minhthangbk/ztachip/HW/src/ztachip_pkg.vhd

---------------------------------------------------------------------------
-- Copyright [2014] [Ztachip Technologies Inc]
--
-- Author: Vuong Nguyen
--
-- Licensed under the Apache License, Version 2.0 (the "License");
-- you may not use this file except in compliance with the License.
-- You may obtain a copy of the License at
--
-- http://www.apache.org/licenses/LICENSE-2.0
--
-- Unless required by applicable law or agreed to in writing, software
-- distributed under the License is distributed on an "AS IS" BASIS,
-- WITHOUT WARRANTIES OR CONDITIONS OF ANY KIND, either express or implied.
-- See the License for the specific language governing permissions and
-- limitations under the License.
---------------------------------------------------------------------------

--------------- 
-- This file defines constants that are used by ztachip implementation
-- Contains component declaration
---------------

library std;
use std.standard.all;
LIBRARY ieee;
USE ieee.std_logic_1164.all;
use IEEE.numeric_std.all;
use IEEE.MATH_REAL.ALL;
use work.config.all;

package ztachip_pkg is

---------
-- Number of threads
---------

constant tid_max_c:integer:=16;

subtype tid_t is unsigned(3 DOWNTO 0);

subtype tid_mask_t  is std_logic_vector(tid_t'length-1 downto 0);

--------
-- Message queue to communicate with host
--------

constant msgq_in_num_c          :integer:=2;                        -- Number of inbox fifo

constant msgq_in_depth_c        :integer:=11;                       -- number of bits required to represent number of inbox messages

constant msgq_in_max_c          :integer:=(2**msgq_in_depth_c-1);   -- inbox size

constant msgq_out_depth_c       :integer:=11;                       -- number of bits required to represent number of outbox messages

constant msgq_out_max_c         :integer:=(2**msgq_out_depth_c-1);  -- outbox size

----------
-- AXI read bus signal definitions
----------

subtype axi_araddr_t is std_logic_vector(31 downto 0);
subtype axi_arlen_t is std_logic_vector(7 downto 0);
subtype axi_arvalid_t is std_logic;     
subtype axi_arid_t is std_logic_vector(0 downto 0);
subtype axi_arlock_t is std_logic_vector(0 downto 0);
subtype axi_arcache_t is std_logic_vector(3 downto 0);
subtype axi_arprot_t is std_logic_vector(2 downto 0);
subtype axi_arqos_t is std_logic_vector(3 downto 0);
subtype axi_rid_t is std_logic_vector(0 downto 0);             
subtype axi_rvalid_t is std_logic;
subtype axi_rlast_t is std_logic;
subtype axi_rdata_t is std_logic_vector(31 downto 0);
subtype axi_rdata64_t is std_logic_vector(63 downto 0);
subtype axi_rdata128_t is std_logic_vector(127 downto 0);
subtype axi_rresp_t is std_logic_vector(1 downto 0);
subtype axi_arready_t is std_logic;
subtype axi_rready_t is std_logic;
subtype axi_arburst_t is std_logic_vector(1 downto 0);
subtype axi_arsize_t is std_logic_vector(2 downto 0);

type axi_araddrs_t is array(natural range <>) of axi_araddr_t;
type axi_arlens_t is array(natural range <>) of axi_arlen_t;
type axi_arvalids_t is array(natural range <>) of axi_arvalid_t; 
type axi_arids_t is array(natural range <>) of axi_arid_t;
type axi_arlocks_t is array(natural range <>) of axi_arlock_t;
type axi_arcaches_t is array(natural range <>) of axi_arcache_t;
type axi_arprots_t is array(natural range <>) of axi_arprot_t;
type axi_arqoss_t is array(natural range <>) of axi_arqos_t;
type axi_rids_t is array(natural range <>) of axi_rid_t;
type axi_rvalids_t is array(natural range <>) of axi_rvalid_t;
type axi_rlasts_t is array(natural range <>) of axi_rlast_t;
type axi_rdatas_t is array(natural range <>) of axi_rdata_t;
type axi_rdata64s_t is array(natural range <>) of axi_rdata64_t;
type axi_rdata128s_t is array(natural range <>) of axi_rdata128_t;
type axi_rresps_t is array(natural range <>) of axi_rresp_t;
type axi_arreadys_t is array(natural range <>) of axi_arready_t;
type axi_rreadys_t is array(natural range <>) of axi_rready_t;
type axi_arbursts_t is array(natural range <>) of axi_arburst_t;
type axi_arsizes_t is array(natural range <>) of axi_arsize_t;

---------------------
-- AXI write bus signals
---------------------

subtype axi_awaddr_t is std_logic_vector(31 downto 0);
subtype axi_awlen_t is std_logic_vector(7 downto 0);
subtype axi_awvalid_t is std_logic;
subtype axi_wvalid_t is std_logic;
subtype axi_wdata_t is std_logic_vector(31 downto 0);
subtype axi_wdata64_t is std_logic_vector(63 downto 0);
subtype axi_wdata128_t is std_logic_vector(127 downto 0);
subtype axi_wlast_t is std_logic;
subtype axi_wstrb_t is std_logic_vector(3 downto 0);
subtype axi_wstrb8_t is std_logic_vector(7 downto 0);
subtype axi_wstrb16_t is std_logic_vector(15 downto 0);
subtype axi_awready_t is std_logic;
subtype axi_wready_t is std_logic;
subtype axi_bresp_t is std_logic_vector(1 downto 0);
subtype axi_bid_t is std_logic_vector(0 downto 0);
subtype axi_bvalid_t is std_logic;
subtype axi_awburst_t is std_logic_vector(1 downto 0);
subtype axi_awcache_t is std_logic_vector(3 downto 0);
subtype axi_awid_t is std_logic_vector(0 downto 0);
subtype axi_awlock_t is std_logic_vector(0 downto 0);
subtype axi_awprot_t is std_logic_vector(2 downto 0);
subtype axi_awqos_t is std_logic_vector(3 downto 0);
subtype axi_awsize_t is std_logic_vector(2 downto 0);
subtype axi_bready_t is std_logic;

type axi_awaddrs_t is array(natural range <>) of axi_awaddr_t;
type axi_awlens_t is array(natural range <>) of axi_awlen_t;
type axi_awvalids_t is array(natural range <>) of axi_awvalid_t;
type axi_wvalids_t is array(natural range <>) of axi_wvalid_t;
type axi_wdatas_t is array(natural range <>) of axi_wdata_t;
type axi_wdata64s_t is array(natural range <>) of axi_wdata64_t;
type axi_wdata128s_t is array(natural range <>) of axi_wdata128_t;
type axi_wlasts_t is array(natural range <>) of axi_wlast_t;
type axi_wstrbs_t is array(natural range <>) of axi_wstrb_t;
type axi_wstrb8s_t is array(natural range <>) of axi_wstrb8_t;
type axi_wstrb16s_t is array(natural range <>) of axi_wstrb16_t;
type axi_awreadys_t is array(natural range <>) of axi_awready_t;
type axi_wreadys_t is array(natural range <>) of axi_wready_t;
type axi_bresps_t is array(natural range <>) of axi_bresp_t;
type axi_bids_t is array(natural range <>) of axi_bid_t;
type axi_bvalids_t is array(natural range <>) of axi_bvalid_t;
type axi_awbursts_t is array(natural range <>) of axi_awburst_t;
type axi_awcaches_t is array(natural range <>) of axi_awcache_t;
type axi_awids_t is array(natural range <>) of axi_awid_t;
type axi_awlocks_t is array(natural range <>) of axi_awlock_t;
type axi_awprots_t is array(natural range <>) of axi_awprot_t;
type axi_awqoss_t is array(natural range <>) of axi_awqos_t;
type axi_awsizes_t is array(natural range <>) of axi_awsize_t;
type axi_breadys_t is array(natural range <>) of axi_bready_t;

--------
--- Constants for MCORE implementation
--------

constant io_depth_c                 :integer:=24;   -- Address width of MCORE external memory access 

constant instruction_width_c        :integer:=128;

constant instruction_byte_width_c   :integer:=(instruction_width_c/8);

constant instruction_depth_c        :integer:=11;   -- mcore code address width

constant instruction_actual_depth_c :integer:=11;   -- mcore code address width

--------
--- PCORE constants
--------

constant vector_depth_c     :integer:=3;  -- vector width in term of number of bits required for addressing

constant host_width_c       :integer:=32;

constant data_byte_width_depth_c :integer:=0;

constant data_byte_width_c  :integer:=(2**data_byte_width_depth_c);

constant data_width_c       :integer:=(8*data_byte_width_c);

constant vector_width_c     :integer:=(2**vector_depth_c);    -- Vector width

constant accumulator_width_c:integer:=32;   -- accumulator width

constant register_width_c   :integer:=16;   -- register width

constant vaccumulator_width_c:integer:=(accumulator_width_c*vector_width_c);   -- accumulator width

constant vregister_width_c  :integer:=(register_width_c*vector_width_c); -- Width of a vector register

constant register_depth_c   :integer:=(5+vector_depth_c);    -- Address width to access register banks from pcore's threads

constant register_size_c    :integer:=(2**register_depth_c);

constant fu_latency_c       :integer:=6;   -- Floating point math unit execusion latency 

constant pipeline_latency_c :integer:=9;    -- Number of cycles to start a thread instruction IN the pipeline

constant ddr_vector_depth_c :integer:=3;

constant ddr_vector_width_c :integer:=(2**ddr_vector_depth_c);

constant ddr_data_width_c   :integer:=(data_width_c*ddr_vector_width_c);

constant ddr_data_byte_width_c: integer:=(ddr_data_width_c/8);

constant ddr_burstlen_width_c: integer:=4;

constant ddrx_data_width_c  :integer:=(register_width_c*ddr_vector_width_c);

constant ddr_max_burstlen_c:integer:=6;

--constant ddr_max_write_pend_depth_c:integer:=6;

constant ddr_max_write_pend_depth_c:integer:=6;

--constant ddr_max_read_transaction_pend_depth_c:integer:=6;

--constant ddr_max_read_pend_depth_c:integer:=8;

constant ddr_max_read_transaction_pend_depth_c:integer:=6;

constant ddr_max_read_pend_depth_c:integer:=9;

constant ddr_max_write_pend_c:integer:=(2**ddr_max_write_pend_depth_c);

constant ddr_max_read_transaction_pend_c:integer:=(2**ddr_max_read_transaction_pend_depth_c);

constant ddr_max_read_pend_c:integer:=(2**ddr_max_read_pend_depth_c);

constant data_flow_direct_c:integer:=0;

constant data_flow_converge_c:integer:=1;

constant data_flow_diverge_c:integer:=2;

constant data_flow_stream_process_c:integer:=3;

subtype data_flow_t is std_logic_vector(1 DOWNTO 0);

type data_flows_t is array(natural range <>) of data_flow_t;

-- Scatter type

subtype scatter_t is std_logic_vector(1 downto 0);

type scatters_t is array(natural range <>) of scatter_t; 

constant scatter_none_c:scatter_t:="00";  -- Scatter none

constant scatter_vector_c:scatter_t:="01"; -- Scatter among vector elements

constant scatter_thread_c:scatter_t:="10"; -- scatter among threads

-- Fork parameters

constant fork_max_c:integer:=1;

-- FORK for every memory space 

constant fork_pcore_c:integer:=fork_max_c;

constant fork_sram_c:integer:=1;

constant fork_ddr_c:integer:=1;

--------
-- Register file size
--------

constant register_file_depth_c  :integer:=(register_depth_c+tid_t'length); -- Depth of register file

constant register_actual_file_depth_c:integer:=(register_file_depth_c-1); -- Actual size of register file...

constant local_addr_depth_c :integer:=(register_file_depth_c); -- Max address for internal local address (private and shared)

--------
--- SRAM constant
--------

constant sram_bank_depth_c  :integer:=14;   -- Address width to access SRAM bank

constant sram_depth_c       :integer:=15;   -- Address width to access SRAM memory

constant sram_num_bank_c    :integer:=2**(sram_depth_c-sram_bank_depth_c);

--------
--- DDR access window
--------

constant ddr_bus_width_c    :integer:=32;   -- Address width to access DDR window

--- DDR driver parameters

constant ddr_rx_fifo_width_c:integer:=ddr_bus_width_c+ddr_burstlen_width_c+2;

constant ddr_rx_fifo_depth:integer:=4;

constant ddr_rx_fifo_size_c:integer:=(2**ddr_rx_fifo_depth);

----
-- BUS2 address: 
-- This bus is for SRAM and MCORE memory access
------

constant dp_bus2_addr_width_c :integer:=18;

subtype dp_bus2_page_t is std_logic_vector(1 downto 0);

constant dp_bus2_page_sram_c:dp_bus2_page_t:="00";

constant dp_bus2_page_mcore_code_c:dp_bus2_page_t:="01";

--------
--- IALU constants
--------

constant iregister_width_c      :integer:=13;                       -- Bit width of IALU registers

constant iregister_width_log_c  :integer:=4;                        -- log(iregister_width_c)

constant iregister_depth_c      :integer:=3;                        -- Address width to access IALU registers

constant iregister_max_c        :integer:=(2**iregister_depth_c);   -- Max number of IALU registers

--------
-- IALU register datatype
--------

subtype iregister_t         is unsigned(iregister_width_c-1 downto 0);  -- IALU register datatype

subtype iregister_addr_t    is unsigned(iregister_depth_c-1 downto 0);  -- IALU register address datatype

type iregisters_t        is array(natural range <>) of iregister_t;  -- Array if iregister_t

-----
-- iregister override
-----

constant max_iregister_auto_c:integer:=2;

subtype iregister_auto_t  is unsigned(max_iregister_auto_c+iregister_width_c*max_iregister_auto_c-1 downto 0);

type iregister_autos_t is array(natural range <>) of iregister_auto_t;

-------
-- Accumulator register
-------

constant xreg_depth_c:integer:=(3+tid_t'length);

subtype xreg_addr_t is std_logic_vector(xreg_depth_c-1 downto 0);

---------
-- MU Instruction format
-- Instruction opcode field
---------

constant mu_instruction_width_c         :integer:=80;
constant mu_instruction_y_attr_lo_c     :integer:=0; -- LSB bit position of Y field
constant mu_instruction_y_attr_hi_c     :integer:=3; -- MSB bit position of Y field
constant mu_instruction_y_lo_c          :integer:=(mu_instruction_y_attr_hi_c+1); -- LSB bit position of Y field
constant mu_instruction_y_hi_c          :integer:=(mu_instruction_y_lo_c+local_addr_depth_c-1); -- MSB bit position of Y field
constant mu_instruction_y_vector_c      :integer:=(mu_instruction_y_hi_c+1); -- Vector mode
constant mu_instruction_x2_attr_lo_c    :integer:=(mu_instruction_y_vector_c+1); -- LSB Bit position of X2 field
constant mu_instruction_x2_attr_hi_c    :integer:=(mu_instruction_x2_attr_lo_c+3); -- MSB bit position of X2 field
constant mu_instruction_x2_lo_c         :integer:=(mu_instruction_x2_attr_hi_c+1); -- LSB Bit position of X2 field
constant mu_instruction_x2_hi_c         :integer:=(mu_instruction_x2_lo_c+local_addr_depth_c-1); -- MSB bit position of X2 field
constant mu_instruction_x2_vector_c     :integer:=(mu_instruction_x2_hi_c+1); -- vector mode
constant mu_instruction_x1_attr_lo_c    :integer:=(mu_instruction_x2_vector_c+1); -- LSB bit position of X1 field
constant mu_instruction_x1_attr_hi_c    :integer:=(mu_instruction_x1_attr_lo_c+3); -- MSB bit position of X1 field
constant mu_instruction_x1_lo_c         :integer:=(mu_instruction_x1_attr_hi_c+1); -- LSB bit position of X1 field
constant mu_instruction_x1_hi_c         :integer:=(mu_instruction_x1_lo_c+local_addr_depth_c-1); -- MSB bit position of X1 field
constant mu_instruction_x1_vector_c     :integer:=(mu_instruction_x1_hi_c+1); -- Vector mode
constant mu_instruction_x3_attr_lo_c    :integer:=(mu_instruction_x1_vector_c+1); -- LSB bit position of X1 field
constant mu_instruction_x3_attr_hi_c    :integer:=(mu_instruction_x3_attr_lo_c+3); -- MSB bit position of X1 field
constant mu_instruction_x3_lo_c         :integer:=(mu_instruction_x3_attr_hi_c+1); -- LSB bit position of X1 field
constant mu_instruction_x3_hi_c         :integer:=(mu_instruction_x3_lo_c+local_addr_depth_c-1); -- MSB bit position of X1 field
constant mu_instruction_x3_vector_c     :integer:=(mu_instruction_x3_hi_c+1); -- Vector mode

constant mu_instruction_type_save_c     :integer:=(mu_instruction_width_c-6);
constant mu_instruction_oc_lo_c         :integer:=(mu_instruction_width_c-5);
constant mu_instruction_oc_hi_c         :integer:=(mu_instruction_width_c-1);

constant mu_instruction_y_attr_width_c  :integer:=(mu_instruction_y_attr_hi_c-mu_instruction_y_attr_lo_c+1); -- Length of Y field
constant mu_instruction_y_width_c       :integer:=(mu_instruction_y_hi_c-mu_instruction_y_lo_c+1); -- Length of Y field
constant mu_instruction_x2_attr_width_c :integer:=(mu_instruction_x2_attr_hi_c-mu_instruction_x2_attr_lo_c+1); -- Length of X2 field
constant mu_instruction_x2_width_c      :integer:=(mu_instruction_x2_hi_c-mu_instruction_x2_lo_c+1); -- Length of X2 field
constant mu_instruction_x1_attr_width_c :integer:=(mu_instruction_x1_attr_hi_c-mu_instruction_x1_attr_lo_c+1); -- Length of X1 field
constant mu_instruction_x1_width_c      :integer:=(mu_instruction_x1_hi_c-mu_instruction_x1_lo_c+1); -- Length of X1 field
constant mu_instruction_oc_width_c      :integer:=(mu_instruction_oc_hi_c-mu_instruction_oc_lo_c+1);

subtype mu_opcode_t is std_logic_vector(mu_instruction_oc_width_c-1 downto 0);

type mu_opcodes_t is array(natural range <>) of mu_opcode_t;

-------
-- Control instruction
-------

constant ctrl_instruction_width_c           :integer:=16;
constant ctrl_instruction_oc_lo_c           :integer:=ctrl_instruction_width_c-5;
constant ctrl_instruction_oc_hi_c           :integer:=ctrl_instruction_width_c-1;
constant ctrl_instruction_oc_width_c        :integer:=(ctrl_instruction_oc_hi_c-ctrl_instruction_oc_lo_c+1);
constant ctrl_instruction_goto_addr_hi_c    :integer:=instruction_depth_c-1;
constant ctrl_instruction_goto_addr_lo_c    :integer:=0;
constant ctrl_instruction_goto_addr_width_c :integer:=(ctrl_instruction_goto_addr_hi_c-ctrl_instruction_goto_addr_lo_c+1);

------
-- IMU instruction
------

constant imu_instruction_width_c            :integer:=32;
constant imu_instruction_oc_lo_c            :integer:=imu_instruction_width_c-5;
constant imu_instruction_oc_hi_c            :integer:=imu_instruction_width_c-1;
constant imu_instruction_oc_width_c         :integer:=(imu_instruction_oc_hi_c-imu_instruction_oc_lo_c+1);
constant imu_instruction_x1_hi_c            :integer:=26;
constant imu_instruction_x1_lo_c            :integer:=23;
constant imu_instruction_x1_width_c         :integer:=(imu_instruction_x1_hi_c-imu_instruction_x1_lo_c+1);

constant imu_instruction_x2_hi_c            :integer:=22;
constant imu_instruction_x2_lo_c            :integer:=19;
constant imu_instruction_x2_width_c         :integer:=(imu_instruction_x2_hi_c-imu_instruction_x2_lo_c+1);

constant imu_instruction_y_hi_c             :integer:=18;
constant imu_instruction_y_lo_c             :integer:=15;
constant imu_instruction_y_width_c          :integer:=(imu_instruction_y_hi_c-imu_instruction_y_lo_c+1);

constant imu_instruction_const_hi_c         :integer:=14;
constant imu_instruction_const_lo_c         :integer:=imu_instruction_const_hi_c-iregister_width_c+1;
constant imu_instruction_const_width_c      :integer:=(iregister_width_c);

--------
-- IMU instruction parameter type
--------

subtype imu_instruction_parm_t is std_logic_vector(imu_instruction_x1_width_c-1 downto 0);

constant imu_instruction_parm_i0_c      :imu_instruction_parm_t:="0000";    -- IMU parameter is integer#0
constant imu_instruction_parm_i1_c      :imu_instruction_parm_t:="0001";    -- IMU parameter is integer#1
constant imu_instruction_parm_i2_c      :imu_instruction_parm_t:="0010";    -- IMU parameter is integer#2
constant imu_instruction_parm_i3_c      :imu_instruction_parm_t:="0011";    -- IMU parameter is integer#3
constant imu_instruction_parm_p0_c      :imu_instruction_parm_t:="0100";    -- IMU parameter is pointer#0
constant imu_instruction_parm_p1_c      :imu_instruction_parm_t:="0101";    -- IMU parameter is pointer#1
constant imu_instruction_parm_p2_c      :imu_instruction_parm_t:="0110";    -- IMU parameter is pointer#2
constant imu_instruction_parm_p3_c      :imu_instruction_parm_t:="0111";    -- IMU parameter is pointer#3
constant imu_instruction_parm_lane_c    :imu_instruction_parm_t:="1000";     -- Lane control
constant imu_instruction_parm_zero_c    :imu_instruction_parm_t:="1010";    -- IMU parameter is zero
constant imu_instruction_parm_const_c   :imu_instruction_parm_t:="1011";    -- IMU parameter is an immediate constant
constant imu_instruction_parm_tid_c     :imu_instruction_parm_t:="1100";    -- IMU parameter is TID (theadid)
constant imu_instruction_parm_pid_c     :imu_instruction_parm_t:="1101";    -- IMU parameter is PID (pcore id)
constant imu_instruction_parm_result1_c :imu_instruction_parm_t:="1110";     -- IMU parameter is result field from MU
constant imu_instruction_parm_stack_c   :imu_instruction_parm_t:="1111";     -- Stack pointer value

--------
-- MU opcode
--------

constant opcode_null_c                  :STD_LOGIC_VECTOR(mu_instruction_oc_width_c-1 DOWNTO 0):="00000"; -- NOP
constant mu_opcode_assign_c             :STD_LOGIC_VECTOR(mu_instruction_oc_width_c-1 DOWNTO 0):="00001"; -- Y=X1
constant mu_opcode_assign_raw_c         :STD_LOGIC_VECTOR(mu_instruction_oc_width_c-1 DOWNTO 0):="00010"; -- Y=X1
constant mu_opcode_add_c                :STD_LOGIC_VECTOR(mu_instruction_oc_width_c-1 DOWNTO 0):="00011"; -- Y=X1+X2
constant mu_opcode_sub_c                :STD_LOGIC_VECTOR(mu_instruction_oc_width_c-1 DOWNTO 0):="00100"; -- Y=X1-X2
constant mu_opcode_conv_c               :STD_LOGIC_VECTOR(mu_instruction_oc_width_c-1 DOWNTO 0):="00101"; -- Y=CONV(X1)
constant mu_opcode_cmp_lt_c             :STD_LOGIC_VECTOR(mu_instruction_oc_width_c-1 DOWNTO 0):="00110"; -- X1 < X2
constant mu_opcode_cmp_le_c             :STD_LOGIC_VECTOR(mu_instruction_oc_width_c-1 DOWNTO 0):="00111"; -- X1 <= X2
constant mu_opcode_cmp_gt_c             :STD_LOGIC_VECTOR(mu_instruction_oc_width_c-1 DOWNTO 0):="01000"; -- X1 > X2
constant mu_opcode_cmp_ge_c             :STD_LOGIC_VECTOR(mu_instruction_oc_width_c-1 DOWNTO 0):="01001"; -- X1 >= X2
constant mu_opcode_cmp_eq_c             :STD_LOGIC_VECTOR(mu_instruction_oc_width_c-1 DOWNTO 0):="01010"; -- X1 == X2
constant mu_opcode_cmp_ne_c             :STD_LOGIC_VECTOR(mu_instruction_oc_width_c-1 DOWNTO 0):="01011"; -- X1 != X2
constant mu_opcode_mul_c                :STD_LOGIC_VECTOR(mu_instruction_oc_width_c-1 DOWNTO 0):="01100"; -- Y=X1*X2
constant mu_opcode_acc_set_c            :STD_LOGIC_VECTOR(mu_instruction_oc_width_c-1 DOWNTO 0):="01101"; -- ACC=X1
constant mu_opcode_lsb4_c               :STD_LOGIC_VECTOR(mu_instruction_oc_width_c-1 DOWNTO 0):="01111"; -- Get Mantissa+sign part of float number
constant mu_opcode_msb4_c               :STD_LOGIC_VECTOR(mu_instruction_oc_width_c-1 DOWNTO 0):="10000"; -- Get exponent part of float number
constant mu_opcode_set_exponent_c       :STD_LOGIC_VECTOR(mu_instruction_oc_width_c-1 DOWNTO 0):="10001"; -- Set exponent part of float number
constant mu_opcode_set_float_c          :STD_LOGIC_VECTOR(mu_instruction_oc_width_c-1 DOWNTO 0):="10010"; -- Set float from mantissa and exponent
constant mu_opcode_shl_c                :STD_LOGIC_VECTOR(mu_instruction_oc_width_c-1 DOWNTO 0):= "10011"; -- Shift operation on accumulator
constant mu_opcode_shla_c               :STD_LOGIC_VECTOR(mu_instruction_oc_width_c-1 DOWNTO 0):="10100"; -- Shift operation on accumulator
constant mu_opcode_shr_c                :STD_LOGIC_VECTOR(mu_instruction_oc_width_c-1 DOWNTO 0):= "10101"; -- Shift operation on accumulator
constant mu_opcode_shra_c               :STD_LOGIC_VECTOR(mu_instruction_oc_width_c-1 DOWNTO 0):="10110"; -- Shift operation on accumulator
constant mu_opcode_fm_c                 :STD_LOGIC_VECTOR(mu_instruction_oc_width_c-1 DOWNTO 0):="11000"; -- ACC=ACC+X1*X2

--- Fused multiply add-sub opcode definition
constant fm_oc_hi_c                     :integer:=4;
constant fm_oc_lo_c                     :integer:=3;
constant fm_add_sub_c                   :integer:=0; -- fma=1;fms=0
constant fm_neg_c                       :integer:=1; -- fnma|fnms=1; fma|fms=0;
constant fm_xreg_sel_c                  :integer:=2; -- 0 for x1*x2+_A; 1 for x1*_A+x2

--------
-- Control instruction opcodes
--------

constant ctrl_opcode_return_c   :STD_LOGIC_VECTOR(ctrl_instruction_oc_width_c-1 DOWNTO 0):="00001"; -- RETURN
constant ctrl_opcode_jump_lt_c  :STD_LOGIC_VECTOR(ctrl_instruction_oc_width_c-1 DOWNTO 0):="00010"; -- if(X1 < X2) jump
constant ctrl_opcode_jump_le_c  :STD_LOGIC_VECTOR(ctrl_instruction_oc_width_c-1 DOWNTO 0):="00011"; -- if(X1 <= X2) jump
constant ctrl_opcode_jump_gt_c  :STD_LOGIC_VECTOR(ctrl_instruction_oc_width_c-1 DOWNTO 0):="00100"; -- if(X1 > X2) jump
constant ctrl_opcode_jump_ge_c  :STD_LOGIC_VECTOR(ctrl_instruction_oc_width_c-1 DOWNTO 0):="00101"; -- if(X1 >= X2) jump
constant ctrl_opcode_jump_eq_c  :STD_LOGIC_VECTOR(ctrl_instruction_oc_width_c-1 DOWNTO 0):="00110"; -- if(X1 == X2) jump
constant ctrl_opcode_jump_ne_c  :STD_LOGIC_VECTOR(ctrl_instruction_oc_width_c-1 DOWNTO 0):="00111"; -- if(X1 != X2) jump
constant ctrl_opcode_jump_c     :STD_LOGIC_VECTOR(ctrl_instruction_oc_width_c-1 DOWNTO 0):="01000"; -- JUMP
constant ctrl_opcode_func_c     :STD_LOGIC_VECTOR(ctrl_instruction_oc_width_c-1 DOWNTO 0):="01001"; -- FUNC CALL

-------
-- IMU instruction opcode
-------

constant imu_opcode_add_c   :STD_LOGIC_VECTOR(imu_instruction_oc_width_c-1 DOWNTO 0):="00001"; -- Do Y=X1+X2
constant imu_opcode_sub_c   :STD_LOGIC_VECTOR(imu_instruction_oc_width_c-1 DOWNTO 0):="00010"; -- Do Y=X1-X2
constant imu_opcode_mul_c   :STD_LOGIC_VECTOR(imu_instruction_oc_width_c-1 DOWNTO 0):="00011"; -- Do Y=X1*X2
constant imu_opcode_shl_c   :STD_LOGIC_VECTOR(imu_instruction_oc_width_c-1 DOWNTO 0):="00100"; -- Do Y=X1<<X2
constant imu_opcode_shr_c   :STD_LOGIC_VECTOR(imu_instruction_oc_width_c-1 DOWNTO 0):="00101"; -- Do Y=X1>>X2
constant imu_opcode_or_c    :STD_LOGIC_VECTOR(imu_instruction_oc_width_c-1 DOWNTO 0):="00110"; -- Do Y=X1|X2
constant imu_opcode_and_c   :STD_LOGIC_VECTOR(imu_instruction_oc_width_c-1 DOWNTO 0):="00111"; -- Do Y=X1&X2
constant imu_opcode_xor_c   :STD_LOGIC_VECTOR(imu_instruction_oc_width_c-1 DOWNTO 0):="01000"; -- Do Y=X1^X2
constant imu_opcode_lshr_c  :STD_LOGIC_VECTOR(imu_instruction_oc_width_c-1 DOWNTO 0):="01001"; -- Do Y=X1>>X2 (No sign extension)

--------
-- MU constant attribute type
--------

subtype register_attr_t is std_logic_vector(3 downto 0);

constant register_attr_const_p0_c       :integer:=4;    -- Immediate constant #0
constant register_attr_const_null_c     :integer:=5;    -- NULL
constant register_attr_const_result_c   :integer:=6;    -- Hold MU integer return value
constant register_attr_const_tid_c      :integer:=7;    -- Hold MU integer return value
constant register_attr_const_xreg_c     :integer:=8;    -- Hold MU integer return value

---------
-- PCORE memory page
---------

subtype page_t is unsigned(1 DOWNTO 0);

subtype page2_t is unsigned(1 DOWNTO 0);

constant page2_register_c              :page2_t:=to_unsigned(0,page2_t'length); -- Access private memory 

constant page2_shared_register_c       :page2_t:=to_unsigned(1,page2_t'length); -- Access shared memory

constant page2_spe_register_c          :page2_t:=to_unsigned(2,page2_t'length); -- Access shared memory

constant page2_pcore_program_c         :page2_t:=to_unsigned(3,page2_t'length); -- Download PCORE program memory

--------
-- CELL ID
--------

subtype cid_t is unsigned(2 DOWNTO 0);

----------
-- Number of processor per cell
----------

constant pid_max_c:integer:= 4;

subtype pid_t is unsigned(1 DOWNTO 0);

----------
--- Total number of pcores
----------

subtype pcore_t is unsigned(cid_t'length+pid_t'length-1 DOWNTO 0);

---------
-- Avalon bus page
---------

subtype avalon_bus_page_t is unsigned(1 downto 0);

constant avalon_bus_page_config_c:avalon_bus_page_t:=to_unsigned(0,avalon_bus_page_t'length); -- Access configuration registers

constant avalon_bus_page_pcode_c:avalon_bus_page_t:=to_unsigned(1,avalon_bus_page_t'length); -- Access PCORE code space

constant avalon_bus_page_mcode_c:avalon_bus_page_t:=to_unsigned(2,avalon_bus_page_t'length); -- Access MCORE code space

constant avalon_bus_page_mdata_c:avalon_bus_page_t:=to_unsigned(3,avalon_bus_page_t'length); -- Access MCORE data space

--------
-- Constant memory size
--------

constant constant_depth_c: integer:= 8;

-------
-- PCORE bus address
--------

constant bus_width_c:integer:=(register_depth_c+tid_t'length+pid_t'length+cid_t'length); -- Address width to access PCORE

--------
-- AVALON bus address
--------

constant local_bus_width_c:integer:=(bus_width_c+page_t'length+page2_t'length+1); -- Total address width from avalon bus

--------
-- Avalon bus width 
--------

constant avalon_bus_width_c:integer:=17;

--------
-- Avalon bus page width
---------

constant avalon_page_width_c:integer:=(avalon_bus_width_c-avalon_bus_page_t'length);

--------
-- Multicast addr definition
--------

constant mcast_width_c:integer:=1+cid_t'length+pid_t'length; -- multicast address width

subtype mcast_t is std_logic_vector(mcast_width_c-1 downto 0);

subtype mcast_addr_t is STD_LOGIC_VECTOR(cid_t'length+pid_t'length-1 DOWNTO 0); -- multicast address datatype

type mcasts_t is array(natural range <>) of mcast_t; -- array of multicast address datatype

--------
-- PCORE instruction address
--------

subtype instruction_addr_t is STD_LOGIC_VECTOR(instruction_depth_c-1 DOWNTO 0); -- PCORE instruction address datatype

type instruction_addrs_t is array(natural range <>) of instruction_addr_t; -- array of pcore instruction addresses

------
-- General types
------

type integer_array is array (natural range <>) of integer;

subtype vector_t is unsigned(ddr_vector_depth_c downto 0);

type vectors_t is array(natural range <>) of vector_t;

subtype vector_fork_t is vectors_t(fork_max_c-1 downto 0);

type vector_forks_t is array(natural range <>) of vector_fork_t;

--------
-- Floating point type definition
-------

constant fp12_exp_width_c:integer:=4;

constant fp12_mantissa_width_c:integer:=11;

constant fp32_exp_width_c:integer:=8;

constant fp32_mantissa_width_c:integer:=23;

subtype fp12_t is std_logic_vector(15 downto 0); 

subtype bfloat_t is std_logic_vector(15 downto 0);

subtype fp16_t is std_logic_vector(15 downto 0);

subtype fp32_t is std_logic_vector(31 downto 0);

-------
-- FPU type definitions
------

subtype fpu_opcode_t is unsigned(3 downto 0); 

--------
-- DP Read latency
--------

constant read_latency_register_c    :integer:=8; -- Latency of PCORE read access

constant read_latency_sram_c        :integer:=4; -- Latency of SRAM read access

constant read_latency_ddr_c         :integer:=1; -- Latency of DDR read access

constant read_latency_max_c         :integer:=8;  -- Warning . Below is the max of all previously defined latency

--------
-- DP data converter latency
--------

constant convert_latency_c          :integer:=6; -- Latency of data converted to/from DDR

-------
-- DDR burst definition
-------

constant burstlen_width_c:integer:=(ddr_burstlen_width_c-1+ddr_vector_depth_c);

subtype burstlen_t is unsigned(burstlen_width_c-1 downto 0);                 -- DDR bustlen definition

subtype burstlen2_t is unsigned(burstlen_width_c+ddr_vector_depth_c+1-1 downto 0);                 -- DDR bustlen definition

constant burstlen_max_c:integer:=(2**burstlen_t'length-1);  -- DDR bustlen size

type burstlens_t is array(natural range <>) of burstlen_t;  -- array of burstlen_t

--------
-- DP sink parameters
--------

constant dp_sink_fifo_depth_c       :integer:=8;

constant dp_sink_fifo_size_c        :integer:=(2**dp_sink_fifo_depth_c); -- WARNING. Must be > burstlength+dp_sink_fifo_full_margin_c 

--------
-- Data plane processor's bus...
--------

-- Constant for DP processor 

constant NUM_DP_SRC_PORT:integer:=3;

constant NUM_DP_DST_PORT:integer:=3;

constant dp_bus_id_register_c   :integer:=0; -- DP bus to access PCORE memory space

constant dp_bus_id_sram_c       :integer:=1; -- DP bus to access SRAM

constant dp_bus_id_ddr_c        :integer:=2; -- DP bus to access DDR

constant dp_bus_id_max_c        :integer:=3; -- Max number of DP bus

subtype dp_bus_id_t is unsigned(1 downto 0); -- DP busid datatype

-- 
-- Max number of DP generator
----

constant dp_max_gen_c:integer:=2;

-------
-- DP memory model
-- '00' for full model (all threads active)
-- '01' for 1/2 threads active
-- '10' for 1/4 threads active
-- '11' for 1/8 threads active
-------

subtype dp_data_model_t is std_logic_vector(1 downto 0);

type dp_data_models_t is array(natural range <>) of dp_data_model_t; 

--------
-- DP Data type
--------

subtype dp_data_type_t is unsigned(1 downto 0);          -- DP datatype

constant dp_data_type_integer_c     :dp_data_type_t:="01";    -- DP datatype is integer

constant dp_data_type_uinteger_c    :dp_data_type_t:="10";    -- DP datatype is integer

constant dp_data_type_bfloat_c      :dp_data_type_t:="11";    -- DP datatype is integer

type dp_data_types_t is array(natural range <>) of dp_data_type_t;  -- array of DP datatypes

--------
--- DP window address width
---------

constant dp_addr_width_c: integer:=MAX_TENSOR_LOG2_SIZE;

---
-- Full address for DP engine
----
constant dp_full_addr_width_c: integer:=32;

---------
--- Stream processor
---------

constant stream_lookup_depth_c:integer:=9;

constant stream_lookup_size_c:integer:=(2**stream_lookup_depth_c);

constant stream_register_width_c:integer:=12; -- Max width of data to be interpolated by streamer

subtype stream_id_t is unsigned(1 downto 0); -- stream id datatype

type stream_ids_t is array(natural range <>) of stream_id_t;

---------
-- DP instruction fifo depth. This fifo is where mcore is pushing instructions to
---------

constant dp_fifo_depth_c :integer:=7;

constant dp_fifo_max_c :integer:=(2**dp_fifo_depth_c-1);

constant dp_fifo_priority_depth_c :integer:=4;

constant dp_fifo_priority_max_c :integer:=(2**dp_fifo_priority_depth_c-1);

-- DP fifo to transfer instruction to source/sink components

constant dp_fifo2_depth_c :integer:=2;

constant dp_fifo2_max_c :integer:=3;

----------
-- DP data transfer instruction template
---------

type dp_template_t is
record
    stride0: unsigned(dp_addr_width_c-1 downto 0);          -- Increment step for outer loop
    stride0_count: unsigned(dp_addr_width_c-1 downto 0);    -- Number of increment steps for outer loop
    stride0_max: unsigned(dp_addr_width_c downto 0);        -- Max value for stride0
    stride0_min: unsigned(dp_addr_width_c downto 0);        -- Max value for stride0
    stride1: unsigned(dp_addr_width_c-1 downto 0);          -- Increment step for mid loop
    stride1_count: unsigned(dp_addr_width_c-1 downto 0);    -- Number of increment steps for mid loop
    stride1_max: unsigned(dp_addr_width_c downto 0);        -- Max value for stride1
    stride1_min: unsigned(dp_addr_width_c downto 0);        -- Max value for stride0
    stride2: unsigned(dp_addr_width_c-1 downto 0);          -- Increment step for inner loop
    stride2_count: unsigned(dp_addr_width_c-1 downto 0);    -- Number of increment steps for inner loop
    stride2_max: unsigned(dp_addr_width_c downto 0);        -- Max value for stride2
    stride2_min: unsigned(dp_addr_width_c downto 0);        -- Max value for stride2
    stride3: unsigned(dp_addr_width_c-1 downto 0);          -- Increment step for inner loop
    stride3_count: unsigned(dp_addr_width_c-1 downto 0);    -- Number of increment steps for inner loop
    stride3_max: unsigned(dp_addr_width_c downto 0);        -- Max value for stride3
    stride3_min: unsigned(dp_addr_width_c downto 0);        -- Max value for stride3
    stride4: unsigned(dp_addr_width_c-1 downto 0);          -- Increment step for inner loop
    stride4_count: unsigned(dp_addr_width_c-1 downto 0);    -- Number of increment steps for inner loop
    stride4_max: unsigned(dp_addr_width_c downto 0);        -- Max value for stride4
    stride4_min: unsigned(dp_addr_width_c downto 0);        -- Max value for stride4
    burst_max: unsigned(dp_addr_width_c downto 0);          -- Max value for burst
    burst_max2: unsigned(dp_addr_width_c downto 0);         -- Max value for burst
    burst_max_init: unsigned(dp_addr_width_c downto 0);
    burst_max_index: unsigned(2 downto 0);
    burst_min: unsigned(dp_addr_width_c downto 0);          -- Max value for burst
    bar: unsigned(dp_full_addr_width_c-1 downto 0);         -- Base address of this transfer
    count:unsigned(dp_addr_width_c-1 downto 0);             -- Number of transfer
    burstStride:unsigned(dp_addr_width_c-1 downto 0);       -- Increment after each transfer
    double_precision:std_logic;
    data_model:dp_data_model_t;
    scatter:std_logic;
    totalcount:unsigned(dp_addr_width_c-1 downto 0);        -- Total transfer count
    mcast:std_logic_vector(mcast_width_c-1 downto 0);       -- Multicast mask
    data:std_logic_vector(2*data_width_c-1 downto 0);       -- Constant data value
    repeat:std_logic;                                       -- Repeat mode
    datatype:dp_data_type_t;                                -- Data type
    bus_id:dp_bus_id_t;                                     -- Bus ID
    bufsize:unsigned(dp_addr_width_c-1 downto 0);           -- Max buffer size
    burst_max_len:unsigned(dp_addr_width_c-1 downto 0);     -- Max burst length
end record;

constant dp_template_width_c :integer:=26*dp_addr_width_c+dp_full_addr_width_c+14+2+3+dp_addr_width_c+mcast_width_c+2*data_width_c+1+dp_data_type_t'length+dp_bus_id_t'length+dp_addr_width_c+dp_data_model_t'length+dp_addr_width_c;

constant dp_template_id_depth_c :integer:=4;

constant dp_template_max_c :integer:=(2**dp_template_id_depth_c);

constant dp_template_id_src_c :integer:=(dp_template_max_c-2);  -- DP template is source

constant dp_template_id_dest_c :integer:=(dp_template_max_c-1); -- DP template is destination 

subtype dp_template_id_t is unsigned(dp_template_id_depth_c-1 downto 0); -- DP template ID

---------
-- DP datatypes
---------

subtype dp_addr_t is unsigned(dp_addr_width_c-1 downto 0);  -- DP address
type dp_addrs_t is array(natural range <>) of dp_addr_t;  -- array of DP addresses
subtype dp_full_addr_t is unsigned(dp_full_addr_width_c-1 downto 0); -- DP address
type dp_full_addrs_t is array(natural range <>) of dp_full_addr_t;-- array of DP addresses
subtype dp_fork_addr_t is dp_addrs_t(fork_max_c-1 downto 0);
type dp_fork_addrs_t is array(natural range <>) of dp_fork_addr_t;
subtype dp_fork_full_addr_t is dp_full_addrs_t(fork_max_c-1 downto 0); 
type dp_fork_full_addrs_t is array(natural range <>) of dp_fork_full_addr_t;
subtype dp_data_t is std_logic_vector(ddr_data_width_c-1 DOWNTO 0); -- DP data word
type dp_datas_t is array(natural range <>) of dp_data_t; -- array of DP data words
subtype dp_fork_data_t is dp_datas_t(fork_max_c-1 downto 0);
type dp_fork_datas_t is array(natural range <>) of dp_fork_data_t; -- array of DP data words
type dp_bus_ids_t is array(natural range <>) of dp_bus_id_t; -- DP bus id
subtype dp_counter_t is unsigned(dp_addr_width_c-1 downto 0); -- DP transfer counter
type dp_counters_t is array(natural range <>) of dp_counter_t; -- array of DP tranfer counter
subtype dp_vector_t is std_logic_vector(ddr_vector_depth_c-1 downto 0); -- DP vector depth
type dp_vectors_t is array(natural range <>) of dp_vector_t; -- array of DP vector depth
subtype dp_fork_t is std_logic_vector(fork_max_c-1 downto 0); -- DP fork
type dp_forks_t is array(natural range <>) of dp_fork_t; -- array of DP fork
subtype dp_datax_t is STD_LOGIC_VECTOR(ddrx_data_width_c-1 DOWNTO 0);
type dp_dataxs_t is array(natural range <>) of dp_datax_t;

-----------
-- DP condition definitions...
-----------

constant dp_condition_register_flush_c:integer:=0; -- Wait for all write to register space of process 0 to be completed

constant dp_condition_sram_flush_c:integer:=1; -- Wait for all read/write to scratch space of process 0 to be completed

constant dp_condition_fpu_idle_c:integer:=2; -- FPU is idle

constant dp_condition_ddr_flush_c:integer:=3; -- Wait for all write to DDR space to be completed

subtype dp_condition_t is std_logic_vector(3 downto 0); -- DP condition datatype

----------
-- DP opcode
----------

constant dp_opcode_null_c          :integer:=0;    -- Do nothing
constant dp_opcode_transfer_c      :integer:=1;    -- Perform single data transfer
constant dp_opcode_exec_vm_c       :integer:=4;    -- Launch process#0 (Was 2)
constant dp_opcode_indication_c    :integer:=6;    -- Send an indication signal back to mcore
constant dp_opcode_log_on_c        :integer:=2;    -- Enable log
constant dp_opcode_log_off_c       :integer:=3;    -- Disable log
constant dp_opcode_print_c         :integer:=7;    -- Send debug print message
constant dp_opcode_fpu_exe_c       :integer:=5;    -- Execute FPU unit
subtype dp_opcode_t is unsigned(2 downto 0);       -- DP opcode datatype


--------
-- DP config commands sent to PCORE
--------

subtype dp_config_reg_t is unsigned(2 downto 0);
constant dp_config_reg_exe_vm1_c :dp_config_reg_t:="000";
constant dp_config_reg_exe_vm2_c :dp_config_reg_t:="001";

--------
-- DP indication
--------

constant dp_indication_depth_c :integer:=8;    -- FIFO depth to send indication back to mcore
constant dp_indication_max_c :integer:=(2**dp_indication_depth_c-1);

--------
-- DP threads. To be implemented 
--------

constant dp_max_thread_c:integer:=2;
subtype dp_thread_t is unsigned(0 downto 0);
type dp_threads_t is array(natural range <>) of dp_thread_t;

-------
-- DP log
------

constant log_depth_c:integer:=7;
constant log_max_c:integer:=(2**log_depth_c);
subtype log_type_t is std_logic_vector(1 downto 0);
constant log_type_none_c:log_type_t:="00"; -- No log event
constant log_type_dp_begin_c:log_type_t:="01"; -- Begin of a DP transfer command
constant log_type_print_c:log_type_t:="10"; -- Debug print. Parameter point to a string 
constant log_type_status_c:log_type_t:="11"; -- Log is full event. There may be some missing events after this

------
-- Definition for log status.
-- Log status is the log_status_max_c LSB bit in the word retrieved from log FIFO
-- The rest MSB bits (log_timestamp_c number bits) is the time stamp when the status happened
------

constant log_timestamp_c:integer:=20; -- Size of log timestamp field.
constant log_status_max_c:integer:=12; -- Max number of log status bits
constant log_status_vm0_busy_c:integer:=0; -- PCORE process #0 is busy
constant log_status_vm1_busy_c:integer:=1; -- PCORE process #1 is busy
constant log_status_register_vm0_write_busy_c:integer:=2; -- Write bus to PCORE memory space is busy
constant log_status_register_vm0_read_busy_c:integer:=3; -- Read bus from PCORE memory space is busy
constant log_status_sram_vm0_write_busy_c:integer:=4; -- Write bus to SRAM memory space is busy
constant log_status_sram_vm0_read_busy_c:integer:=5; -- Read bus from SRAM memory space is busy
constant log_status_register_vm1_write_busy_c:integer:=6; -- Write bus to PCORE memory space is busy
constant log_status_register_vm1_read_busy_c:integer:=7; -- Read bus from PCORE memory space is busy
constant log_status_sram_vm1_write_busy_c:integer:=8; -- Write bus to SRAM memory space is busy
constant log_status_sram_vm1_read_busy_c:integer:=9; -- Read bus from SRAM memory space is busy
constant log_status_ddr_write_busy_c:integer:=10; -- Write bus to DDR memory space is busy
constant log_status_ddr_read_busy_c:integer:=11; -- Read bus from DDR memory space is busy

----------------
-- DP instruction format
---------

type dp_instruction_t is
record
    opcode:dp_opcode_t;                                 -- opcode
    condition:dp_condition_t;                           -- wait condition
    vm:std_logic;                                       -- Thread associated with this transfer
    source:dp_template_t;                               -- source for transfer command
    source_bus_id: dp_bus_id_t;                         -- source bus-id
    source_data_type:dp_data_type_t;                    -- source data-type
    dest:dp_template_t;                                 -- destination for transfer command
    dest_bus_id: dp_bus_id_t;                           -- destination bus-id
    dest_data_type:dp_data_type_t;                      -- destination data-type
    mcast:std_logic_vector(mcast_width_c-1 downto 0);   -- Multicast mask
    count:unsigned(dp_addr_width_c-1 downto 0);         -- Number of words for transfer command
    data:std_logic_vector(2*data_width_c-1 downto 0);   -- Constants when source is constant type
    repeat:std_logic;                                   -- Source is in repeat mode
    source_addr_mode:std_logic;                         -- Source memory model
    dest_addr_mode:std_logic;                           -- Dest memory model
    stream_process:std_logic;
    stream_process_id:stream_id_t;
end record;

-- dp_instruction_t width

constant dp_instruction_width_c :integer:=(57*dp_addr_width_c+2*dp_full_addr_width_c+2*dp_data_model_t'length+14*2+3*2+2*dp_bus_id_t'length+2*dp_data_type_t'length+2*1+dp_condition_t'length+dp_opcode_t'length+1+mcast_width_c+2*data_width_c+1+2+2+1+stream_id_t'length);

-- Array of dp_instruction_t

type dp_instructions_t is array(natural range <>) of dp_instruction_t;

-- Number of parameters for each DP indication events

constant dp_indication_num_parm_c   :integer:=2;

----------
-- Other DP instruction besides DP transfer command
----------

type dp_instruction_generic_t is
record
    opcode:dp_opcode_t;
    condition:dp_condition_t;
    vm:std_logic;
    param:std_logic_vector(host_width_c-dp_opcode_t'length-dp_condition_t'length-1 downto 0);
    parameters:std_logic_vector(host_width_c*dp_indication_num_parm_c-1 downto 0);
end record;

-------------
-- Register definitions
-------------

subtype register_t is unsigned(4 downto 0);

subtype register2_t is unsigned(6 downto 0);

subtype register_addr_t is std_logic_vector(register_t'length+register2_t'length+1-1 downto 0);

constant register_ddr_bar_c                     :integer:=1;  -- Set DDR start window address
constant register_dp_read_log_c                 :integer:=2;  -- Read LOG fifo
constant register_dp_read_log_time_c            :integer:=3;  -- Read LOG fifo
constant register_dp_run_c                      :integer:=5;  -- Execute a data plane command
constant register_lookup_set_addr_c             :integer:=6;  -- Setup lookup address for subsequent update
constant register_lookup_value_c                :integer:=7;  -- Set lookup table value     
constant register_lookup_coefficient_c          :integer:=4;  -- Set lookup remainder slope coefficient    
constant register_dp_template_c                 :integer:=8;  -- Set DP transfer source
constant register_dp_read_sync_c                :integer:=10; -- Read indication is sync or not
constant register_dp_read_indication_c          :integer:=11; -- Read indication fifo
constant register_dp_read_indication_avail_c    :integer:=12; -- Read number of indication words available IN fifo
constant register_dp_instruction_fifo_avail_c   :integer:=14; -- Read number of DP instruction that can still be pushed to fifo
constant register_soft_reset_c                  :integer:=15; -- Perform soft reset
constant register_swdl_complete_read_c          :integer:=20; -- Number of completed mcore program write words completed
constant register_swdl_complete_clear_c         :integer:=21; -- Clear number of completed mcore program write words completed
constant register_msgq_read_c                   :integer:=16; -- Read commands from host
constant register_msgq_read_avail_c             :integer:=17; -- Read how many commands from host available to be read
constant register_msgq_write_c                  :integer:=18; -- Write commands to host
constant register_msgq_write_avail_c            :integer:=19; -- Read how many commands to host that can be pushed to fifo
constant register_dp_max_pcore_c                :integer:=22; -- Set max number of PCORE
constant register_dp_indication_parm0_c         :integer:=23; -- Read indication parm0
constant register_dp_indication_parm1_c         :integer:=24; -- Read indication parm1
constant register_dp_read_indication_parm_c     :integer:=25; -- Read indication message-id
constant register_fpu_set_c                     :integer:=26; -- Read serial port
constant register_fpu_exe_c                     :integer:=27; -- Write serial port
constant register_fpu_get_status_c              :integer:=28; -- Number of bytes available in serial port for reading
constant register_fpu_set_mem                   :integer:=31; -- Set memory page for FPU(per VM)
constant register_serial_write_avail_c          :integer:=29; -- Number of bytes that can be sent on serial port
constant register_dp_resume_c                   :integer:=30; -- Number of bytes that can be sent on serial port
constant register_dp_restore_c                  :integer:=13; -- Restore dp_register to a source
constant register_vm_toggle_c                   :integer:=9;  -- Toggle current VM

---------------------
-- Sub register values associated with register_fpu_set_c
-- General formula: A = B+C*X*Y;
-- There are 3 sub-fields
--    P: Paramter
--    M: mode; 0=value;1=address
--    W: 0=fp16;1=fp32;2=int8;3=fp32-floor
-- Register bit field has this format: WW M PPP 
---------------------
constant register2_fpu_set_P_MASK       :std_logic_vector(6 downto 0):="0000111"; -- Bit mask for P subfield
constant register2_fpu_set_M_MASK       :std_logic_vector(6 downto 0):="0001000"; -- Bit mask for M subfield 
constant register2_fpu_set_W_MASK       :std_logic_vector(6 downto 0):="1110000"; -- Bit mask for W subfield
constant register2_fpu_set_P_A          :integer:=0; -- P subfield to set A parameter
constant register2_fpu_set_P_B          :integer:=1; -- P subfield to set B parameter
constant register2_fpu_set_P_C          :integer:=2; -- P subfield to set C parameter
constant register2_fpu_set_P_X          :integer:=3; -- P subfield to set X parameter
constant register2_fpu_set_P_Y          :integer:=4; -- P subfield to set Y parameter
constant register2_fpu_set_P_CNT        :integer:=5; -- P subfield to set CNT parameter
constant register2_fpu_set_P_C2         :integer:=6; -- P subfield to set C2 parameter
constant register2_fpu_set_W_BFLOAT     :integer:=0; -- W subfield for BFLOAT data type
constant register2_fpu_set_W_FP32       :integer:=16; -- W subfield for FP32 data type.
constant register2_fpu_set_W_INT16      :integer:=32; -- W subfield for INT16 data type.
constant register2_fpu_set_W_ZFP16      :integer:=48; -- W subfield for ztachip custom FP16
constant register2_fpu_set_W_FP16       :integer:=64; -- W subfield for FP16 data type
constant register2_fpu_set_M_VALUE      :integer:=0; -- M subfield for access by value
constant register2_fpu_set_M_ADDR       :integer:=8; -- M subfield for access by SRAM address

-------
-- Sub register values associated with register_fpu_exe_c
-- 3 types of opcodes (defined by subfields below) that can be executed 
-- same time
--
-- A F XXXX
--    A = ABS
--    F = FLOOR
--    XXXX = fpu_opcode_t; 1->MAC;2->MAX;3->RECIPROCAL;4->SUM 
------

constant register2_fpu_exe_A_MASK_c:std_logic_vector:="100000";

constant register2_fpu_exe_F_MASK_c:std_logic_vector:="010000";

constant register2_fpu_exe_X_MASK_c:std_logic_vector:="001111";



constant register2_fpu_exe_mac_c:integer:=1; -- A = B + C*X*Y;

constant register2_fpu_exe_group_max_c:integer:=2; -- A = MAX(B) in group of C items

constant register2_fpu_exe_reciprocal_c:integer:=3; -- A=1/B (approximated only)

constant register2_fpu_exe_sum_c:integer:=4; -- A = SUM(B)

constant register2_fpu_exe_exp_c:integer:=5; -- A = 2**B where B is INT8

constant register2_fpu_exe_max_c:integer:=6; -- A = MAX(B) of all items

constant register2_fpu_exe_fma_c:integer:=7; -- FMA

constant register2_fpu_exe_inv_sqrt_c:integer:=8; -- INV_SQRT

constant register2_fpu_exe_floor_c:integer:=16; --A=FLOOR

constant register2_fpu_exe_abs_c:integer:=32; --A=ABS

--------------------------
-- Sub register values associated with register_dp_src_template_c and register_dp_dest_template_c 
--------------------------
constant register2_dp_stride0_c         :integer:=0;    -- Set outer loop stride count
constant register2_dp_stride0_count_c   :integer:=1;    -- Set outer loop count
constant register2_dp_stride1_c         :integer:=2;    -- Set mid loop stride count
constant register2_dp_stride1_count_c   :integer:=3;    -- Set mid loop count
constant register2_dp_bar_c             :integer:=4;    -- Set transfer base address
constant register2_dp_count_c           :integer:=5;    -- Set word count for each interation
constant register2_dp_stride2_c         :integer:=6;    -- Set inner loop stride count
constant register2_dp_stride2_count_c   :integer:=7;    -- Set inner loop count
constant register2_dp_burst_stride_c    :integer:=8;    -- Set stride used each interation transfer
constant register2_dp_stride0_max_c     :integer:=9;    -- Set max loop count
constant register2_dp_stride1_max_c     :integer:=10;   -- Set max loop count
constant register2_dp_stride2_max_c     :integer:=11;   -- Set max loop count
constant register2_dp_burst_max_c       :integer:=12;   -- Set max burst length
constant register2_dp_burst_max2_c      :integer:=27;   -- Set max burst length for last element
constant register2_dp_stride3_c         :integer:=13;   -- Set outer loop stride count
constant register2_dp_stride3_count_c   :integer:=14;   -- Set outer loop count
constant register2_dp_stride3_max_c     :integer:=15;   -- Set max loop count
constant register2_dp_stride4_c         :integer:=16;   -- Set outer loop stride count
constant register2_dp_stride4_count_c   :integer:=17;   -- Set outer loop count
constant register2_dp_stride4_max_c     :integer:=18;   -- Set max loop count
constant register2_dp_mode_c            :integer:=19;   -- Transfer mode: full precision(bit0)/scatter(bit1)
constant register2_dp_stride0_min_c     :integer:=20;   -- Set max loop count
constant register2_dp_stride1_min_c     :integer:=21;   -- Set max loop count
constant register2_dp_stride2_min_c     :integer:=22;   -- Set max loop count
constant register2_dp_stride3_min_c     :integer:=23;   -- Set max loop count
constant register2_dp_stride4_min_c     :integer:=24;   -- Set max loop count
constant register2_dp_burst_min_c       :integer:=25;   -- Set max burst length
constant register2_dp_totalcount_c      :integer:=26;   -- Set total transfer size
constant register2_dp_data_c            :integer:=28;   -- Constant data
constant register2_dp_fork_stride_c     :integer:=29;   -- Fork stride
constant register2_dp_fork_count_c      :integer:=30;   -- Fork count
constant register2_dp_bufsize_c         :integer:=31;   -- Set transfer base address
constant register2_dp_burst_max_init_c  :integer:=32;   -- Initial value of burst_max
constant register2_dp_burst_max_index_c :integer:=33;   -- stride index where last entry changes burst_max
constant register2_dp_burst_max_len_c   :integer:=34;   -- burst max length

----------
--- APB register map
---------

constant apb_max_devices_c:integer:=16;

constant apb_base_addr_len_c:integer:=16;

constant apb_addr_len_c:integer:=20;

constant apb_base_mask_c:std_logic_vector:="11110000000000000000";

-- GPIO Peripherals

constant apb_gpio_id_c:integer:=0;

constant apb_led_base_c:integer:=(apb_gpio_id_c * 2**16);

constant apb_led_c:integer:=apb_led_base_c+0;

constant apb_pb_c:integer:=apb_led_base_c+4;

-- WRITE VDMA/CAMERA peripherals

constant apb_wvdma_id_c:integer:=1;

constant apb_wvdma_base_c:integer:=(apb_wvdma_id_c * 2**16);

constant apb_wvdma_enable_c:integer:=apb_wvdma_base_c+0; 

constant apb_wvdma_get_curr_c:integer:=apb_wvdma_base_c+4;  

constant apb_wvdma_buf0_c:integer:=apb_wvdma_base_c+8;

constant apb_wvdma_buf1_c:integer:=apb_wvdma_base_c+12;

constant apb_wvdma_buf2_c:integer:=apb_wvdma_base_c+16;

constant apb_wvdma_buf3_c:integer:=apb_wvdma_base_c+20;

-- READ VDMA/VIDEO peripherals

constant apb_rvdma_id_c:integer:=2;

constant apb_rvdma_base_c:integer:=(apb_rvdma_id_c * 2**16);

constant apb_rvdma_enable_c:integer:=apb_rvdma_base_c+0; 

constant apb_rvdma_get_curr_c:integer:=apb_rvdma_base_c+4;  

constant apb_rvdma_buf0_c:integer:=apb_rvdma_base_c+8;

constant apb_rvdma_buf1_c:integer:=apb_rvdma_base_c+12;

constant apb_rvdma_buf2_c:integer:=apb_rvdma_base_c+16;

constant apb_rvdma_buf3_c:integer:=apb_rvdma_base_c+20;

-- UART peripheral

constant apb_uart_id_c:integer:=3;

constant apb_uart_base_c:integer:=(apb_uart_id_c * 2**16);

constant apb_uart_read_c:integer:=apb_uart_base_c+0;

constant apb_uart_write_c:integer:=apb_uart_base_c+4;

constant apb_uart_read_avail_c:integer:=apb_uart_base_c+8;

constant apb_uart_write_avail_c:integer:=apb_uart_base_c+12;

-- TIMER peripheral

constant apb_time_id_c:integer:=4;

constant apb_time_base_c:integer:=(apb_time_id_c * 2**16);

constant apb_time_get_c:integer:=apb_time_base_c+0;

constant apb_time2_get_c:integer:=apb_time_base_c+4;

-- SPI peripheral

constant apb_spi_id_c:integer:=5;

constant apb_spi_base:integer:=(apb_spi_id_c * 2**16);

constant apb_spi_config:integer:=apb_spi_base+0;

constant apb_spi_status:integer:=apb_spi_base+4;

constant apb_spi_read_req:integer:=apb_spi_base+8;

constant apb_spi_read:integer:=apb_spi_base+12;

constant apb_spi_write_req:integer:=apb_spi_base+16;

constant apb_spi_write:integer:=apb_spi_base+20;

-- Ethernet peripheral

constant apb_ethlite_id_c:integer:=6;

constant apb_ethlite_base:integer:=(apb_ethlite_id_c * 2**16);


---------------------------------------------------------------------------
--                       Function definition
-------------------------------------------------------------------------

function real_to_float32(input_real: real) return fp32_t;

function float32_to_real(input_float: fp32_t) return real;

function log2(n : natural) return natural;

-----------------------------------------------------------------------------
--
--                       Component declaration
--
-----------------------------------------------------------------------------

component ztachip IS
    generic (
        FPU_ENABLED :boolean
        );
    port(   
            clock_in                      : IN STD_LOGIC;
            clock_x2_in                   : IN STD_LOGIC;
            reset_in                      : IN STD_LOGIC;                       
                    
            debug_in                      :IN STD_LOGIC_VECTOR(3 downto 0);

            axi_araddr_out                : OUT std_logic_vector(ddr_bus_width_c-1 downto 0);
            axi_arlen_out                 : OUT unsigned(ddr_burstlen_width_c-1 downto 0);
            axi_arvalid_out               : OUT std_logic;
            axi_rvalid_in                 : IN std_logic;
            axi_rlast_in                  : IN std_logic;
            axi_rdata_in                  : IN std_logic_vector(ddr_data_width_c-1 downto 0);
            axi_arready_in                : IN std_logic;
            axi_rready_out                : OUT std_logic;
            axi_arburst_out               : OUT std_logic_vector(1 downto 0);
            axi_arcache_out               : OUT std_logic_vector(3 downto 0);
            axi_arid_out                  : OUT std_logic_vector(0 downto 0);
            axi_arlock_out                : OUT std_logic_vector(0 downto 0);
            axi_arprot_out                : OUT std_logic_vector(2 downto 0);
            axi_arqos_out                 : OUT std_logic_vector(3 downto 0); 
            axi_arsize_out                : OUT std_logic_vector(2 downto 0);
            
            axi_awaddr_out                : OUT std_logic_vector(ddr_bus_width_c-1 downto 0);
            axi_awlen_out                 : OUT unsigned(ddr_burstlen_width_c-1 downto 0);
            axi_awvalid_out               : OUT std_logic;
            axi_waddr_out                 : OUT std_logic_vector(ddr_bus_width_c-1 downto 0);
            axi_wvalid_out                : OUT std_logic;
            axi_wdata_out                 : OUT std_logic_vector(ddr_data_width_c-1 downto 0);
            axi_wlast_out                 : OUT std_logic;
            axi_wbe_out                   : OUT std_logic_vector(ddr_data_byte_width_c-1 downto 0);
            axi_awready_in                : IN std_logic;
            axi_wready_in                 : IN std_logic;
            axi_bresp_in                  : IN std_logic;
            axi_awburst_out               : OUT std_logic_vector(1 downto 0);
            axi_awcache_out               : OUT std_logic_vector(3 downto 0);
            axi_awid_out                  : OUT std_logic_vector(0 downto 0);
            axi_awlock_out                : OUT std_logic_vector(0 downto 0);
            axi_awprot_out                : OUT std_logic_vector(2 downto 0);
            axi_awqos_out                 : OUT std_logic_vector(3 downto 0);
            axi_awsize_out                : OUT std_logic_vector(2 downto 0);
            axi_bready_out                : OUT std_logic;           
                        
            -- Host interface 

            axilite_araddr_in             : IN std_logic_vector(io_depth_c-1 downto 0);
            axilite_arvalid_in            : IN std_logic;
            axilite_arready_out           : OUT std_logic;
            axilite_rvalid_out            : OUT std_logic;
            axilite_rlast_out             : OUT std_logic;
            axilite_rdata_out             : OUT std_logic_vector(host_width_c-1 downto 0);
            axilite_rready_in             : IN std_logic; 
            axilite_rresp_out             : OUT std_logic_vector(1 downto 0);

            axilite_awaddr_in             : IN std_logic_vector(io_depth_c-1 downto 0);
            axilite_awvalid_in            : IN std_logic;
            axilite_wvalid_in             : IN std_logic;
            axilite_wdata_in              : IN std_logic_vector(host_width_c-1 downto 0);
            axilite_awready_out           : OUT std_logic;
            axilite_wready_out            : OUT std_logic;
            axilite_bvalid_out            : OUT std_logic;
            axilite_bready_in             : IN std_logic;
            axilite_bresp_out             : OUT std_logic_vector(1 downto 0);

            -- AXI slave to access sram
            axislave_araddr_in            : IN STD_LOGIC_VECTOR(31 downto 0);
            axislave_arburst_in           : IN STD_LOGIC_VECTOR(1 downto 0);
            axislave_arlen_in             : IN STD_LOGIC_VECTOR(7 downto 0);
            axislave_arready_out          : OUT STD_LOGIC;
            axislave_arsize_in            : IN STD_LOGIC_VECTOR(2 downto 0);
            axislave_arvalid_in           : IN STD_LOGIC;
            axislave_rdata_out            : OUT STD_LOGIC_VECTOR(31 downto 0);
            axislave_rlast_out            : OUT STD_LOGIC;
            axislave_rready_in            : IN STD_LOGIC;
            axislave_rresp_out            : OUT STD_LOGIC_VECTOR(1 downto 0);
            axislave_rvalid_out           : OUT STD_LOGIC
            );
END component;

COMPONENT host IS
    port(   
            hclock_in                     : IN STD_LOGIC;
            hreset_in                     : IN STD_LOGIC;
            pclock_in                     : IN STD_LOGIC;
            preset_in                     : IN STD_LOGIC;
            mclock_in                     : IN STD_LOGIC;
            mreset_in                     : IN STD_LOGIC;                        
            dclock_in                     : IN STD_LOGIC;
            dreset_in                     : IN STD_LOGIC;                        
            
            avalon_bus_addr_in            : IN std_logic_vector(avalon_bus_width_c-1 downto 0);
            avalon_bus_write_in           : IN std_logic;
            avalon_bus_writedata_in       : IN std_logic_vector(host_width_c-1 downto 0);
            avalon_bus_readdata_out       : OUT std_logic_vector(host_width_c-1 downto 0);
            avalon_bus_wait_request_out   : OUT std_logic;
            avalon_bus_read_in            : IN std_logic;

            -- Communication with ztachip
           
            SIGNAL host_addr_out          : OUT STD_LOGIC_VECTOR(io_depth_c-1 downto 0);
            SIGNAL host_wren_out          : OUT STD_LOGIC;  
            SIGNAL host_rden_out          : OUT STD_LOGIC;      
            SIGNAL host_writedata_out     : OUT STD_LOGIC_VECTOR(host_width_c-1 downto 0);    
            SIGNAL host_readdata_in       : IN STD_LOGIC_VECTOR(host_width_c-1 downto 0);
            SIGNAL host_readdatavalid_in  : IN STD_LOGIC;
            SIGNAL host_waitrequest_in    : IN STD_LOGIC;
            
            SIGNAL indication_avail_out   : OUT STD_LOGIC
            );
END component;

component fifo is
    PORT
    (
        aclr        : IN STD_LOGIC ;
        clock       : IN STD_LOGIC ;
        data        : IN STD_LOGIC_VECTOR (dp_instruction_width_c-1 DOWNTO 0);
        rdreq       : IN STD_LOGIC ;
        wrreq       : IN STD_LOGIC ;
        empty       : OUT STD_LOGIC ;
        full        : OUT STD_LOGIC ;
        q           : OUT STD_LOGIC_VECTOR (dp_instruction_width_c-1 DOWNTO 0);
        usedw       : OUT STD_LOGIC_VECTOR (dp_fifo_depth_c-1 DOWNTO 0)
    );
END component;

component afifo is
	generic 
	(
        DATA_WIDTH  : natural;
        FIFO_DEPTH  : natural
	);
	port 
	(
        rclock_in       : in std_logic;
        wclock_in       : in std_logic;
        reset_in        : in std_logic;
        data_in         : in std_logic_vector(DATA_WIDTH-1 downto 0);
        write_in        : in std_logic;
        read_in         : in std_logic;
        q_out           : out std_logic_vector(DATA_WIDTH-1 downto 0);
        empty_out       : out std_logic;
        full_out        : out std_logic
	);
end component;

component afifo2 is
	generic 
	(
        DATA_WIDTH  : natural;
        FIFO_DEPTH  : natural
	);
	port 
	(
        rclock_in       : in std_logic;
        wclock_in       : in std_logic;
        reset_in        : in std_logic;
        data_in         : in std_logic_vector(DATA_WIDTH-1 downto 0);
        write_in        : in std_logic;
        read_in         : in std_logic;
        q_out           : out std_logic_vector(DATA_WIDTH-1 downto 0);
        empty_out       : out std_logic;
        full_out        : out std_logic
	);
end component;

component rom IS
    PORT (
        SIGNAL clock_in             : IN STD_LOGIC;
        SIGNAL reset_in             : IN STD_LOGIC;
        SIGNAL rdaddress_in         : IN STD_LOGIC_VECTOR (instruction_depth_c-1 DOWNTO 0);
        SIGNAL rdaddress_plus_2_in  : IN STD_LOGIC_VECTOR (instruction_depth_c-1 DOWNTO 0);
        SIGNAL instruction_out      : OUT STD_LOGIC_VECTOR (instruction_width_c-1 DOWNTO 0);
        SIGNAL wren_in              : IN STD_LOGIC;
        SIGNAL wraddress_in         : IN STD_LOGIC_VECTOR(instruction_depth_c-1 DOWNTO 0);
        SIGNAL wrdata_in            : IN STD_LOGIC_VECTOR(instruction_width_c/2-1 DOWNTO 0)
    );
END component;

COMPONENT sram_bank IS
    GENERIC(
        DEPTH       : integer
        );
    PORT (
        SIGNAL clock_in             : IN STD_LOGIC;
        SIGNAL reset_in             : IN STD_LOGIC;
        -- DP interface
        SIGNAL wr_addr_in           : IN STD_LOGIC_VECTOR(DEPTH-1 downto 0);
        SIGNAL byteena_in           : IN STD_LOGIC_VECTOR(ddr_data_byte_width_c-1 downto 0);
        SIGNAL writedata_in         : IN STD_LOGIC_VECTOR(ddr_data_width_c-1 DOWNTO 0);
        SIGNAL wren_in              : IN STD_LOGIC;
        SIGNAL rden_in              : IN STD_LOGIC;
        SIGNAL rd_addr_in           : IN STD_LOGIC_VECTOR(DEPTH-1 downto 0);
        SIGNAL readdata_out         : OUT STD_LOGIC_VECTOR(ddr_data_width_c-1 DOWNTO 0)
    );
END COMPONENT;

COMPONENT sram_core IS
    PORT (
        SIGNAL clock_in                : IN STD_LOGIC;
        SIGNAL reset_in                : IN STD_LOGIC;
        -- DP interface
        SIGNAL dp_rd_addr_in           : IN STD_LOGIC_VECTOR(sram_depth_c-1 DOWNTO 0);
        SIGNAL dp_wr_addr_in           : IN STD_LOGIC_VECTOR(sram_depth_c-1 DOWNTO 0);        
        SIGNAL dp_rd_fork_in           : IN dp_fork_t;
        SIGNAL dp_wr_fork_in           : IN dp_fork_t;
        SIGNAL dp_write_in             : IN STD_LOGIC;
        SIGNAL dp_write_wait_out       : OUT STD_LOGIC;
        SIGNAL dp_write_vector_in      : IN dp_vector_t;
        SIGNAL dp_read_in              : IN STD_LOGIC;
        SIGNAL dp_read_wait_out        : OUT STD_LOGIC;
        SIGNAL dp_read_vm_in           : IN STD_LOGIC;
        SIGNAL dp_read_vector_in       : IN dp_vector_t;
        SIGNAL dp_read_gen_valid_in    : IN STD_LOGIC;
        SIGNAL dp_writedata_in         : IN STD_LOGIC_VECTOR(fork_max_c*ddr_data_width_c-1 DOWNTO 0);
        SIGNAL dp_readdatavalid_out    : OUT STD_LOGIC;
        SIGNAL dp_readdatavalid_vm_out : OUT STD_LOGIC;
        SIGNAL dp_readdata_out         : OUT STD_LOGIC_VECTOR(fork_max_c*ddr_data_width_c-1 DOWNTO 0);

         -- FPU interface
         
        SIGNAL fpu_rd_addr_in           : IN STD_LOGIC_VECTOR(sram_depth_c-1 DOWNTO 0);
        SIGNAL fpu_wr_addr_in           : IN STD_LOGIC_VECTOR(sram_depth_c-1 DOWNTO 0);        
        SIGNAL fpu_write_in             : IN STD_LOGIC;
        SIGNAL fpu_write_wait_out       : OUT STD_LOGIC;
        SIGNAL fpu_read_in              : IN STD_LOGIC;
        SIGNAL fpu_read_wait_out        : OUT STD_LOGIC;
        SIGNAL fpu_writedata_in         : IN STD_LOGIC_VECTOR(ddr_data_width_c-1 DOWNTO 0);
        SIGNAL fpu_writebe_in           : IN STD_LOGIC_VECTOR(ddr_data_width_c/8-1 DOWNTO 0);
        SIGNAL fpu_readdatavalid_out    : OUT STD_LOGIC;
        SIGNAL fpu_readdata_out         : OUT STD_LOGIC_VECTOR(ddr_data_width_c-1 DOWNTO 0);

        -- AXI interface for RISCV to access
        SIGNAL axislave_araddr_in      : IN STD_LOGIC_VECTOR(31 downto 0);
        SIGNAL axislave_arburst_in     : IN STD_LOGIC_VECTOR(1 downto 0);
        SIGNAL axislave_arlen_in       : IN STD_LOGIC_VECTOR(7 downto 0);
        SIGNAL axislave_arready_out    : OUT STD_LOGIC;
        SIGNAL axislave_arsize_in      : IN STD_LOGIC_VECTOR(2 downto 0);
        SIGNAL axislave_arvalid_in     : IN STD_LOGIC;
        SIGNAL axislave_rdata_out      : OUT STD_LOGIC_VECTOR(31 downto 0);
        SIGNAL axislave_rlast_out      : OUT STD_LOGIC;
        SIGNAL axislave_rready_in      : IN STD_LOGIC;
        SIGNAL axislave_rresp_out      : OUT STD_LOGIC_VECTOR(1 downto 0);
        SIGNAL axislave_rvalid_out     : OUT STD_LOGIC
    );
END COMPONENT;

COMPONENT sram IS
    GENERIC(
        DEPTH : integer
        );
    PORT (
        SIGNAL clock_in             : IN STD_LOGIC;
        SIGNAL reset_in             : IN STD_LOGIC;
        -- DP interface
        SIGNAL dp_rd_addr_in        : IN STD_LOGIC_VECTOR(DEPTH-1 DOWNTO 0);
        SIGNAL dp_wr_addr_in        : IN STD_LOGIC_VECTOR(DEPTH-1 DOWNTO 0);        
        SIGNAL dp_write_in          : IN STD_LOGIC;
        SIGNAL dp_write_vector_in   : IN dp_vector_t;
        SIGNAL dp_read_in           : IN STD_LOGIC;
        SIGNAL dp_read_vector_in    : IN dp_vector_t;
        SIGNAL dp_read_gen_valid_in : IN STD_LOGIC;
        SIGNAL dp_writedata_in      : IN STD_LOGIC_VECTOR(ddr_data_width_c-1 DOWNTO 0);
        SIGNAL dp_writebe_in        : IN STD_LOGIC_VECTOR(ddr_data_width_c/8-1 DOWNTO 0);
        SIGNAL dp_readdatavalid_out : OUT STD_LOGIC;
        SIGNAL dp_readdata_out      : OUT STD_LOGIC_VECTOR(ddr_data_width_c-1 DOWNTO 0)
    );
END COMPONENT;

COMPONENT fpu IS
    PORT (
        SIGNAL clock_in                 : IN STD_LOGIC;
        SIGNAL reset_in                 : IN STD_LOGIC;

        -- Bus interface for configuration        
        SIGNAL bus_waddr_in             : IN register_addr_t;
        SIGNAL bus_raddr_in             : IN register_addr_t;
        SIGNAL bus_write_in             : IN STD_LOGIC;
        SIGNAL bus_read_in              : IN STD_LOGIC;
        SIGNAL bus_writedata_in         : IN STD_LOGIC_VECTOR(host_width_c-1 DOWNTO 0);
        SIGNAL bus_readdata_out         : OUT STD_LOGIC_VECTOR(host_width_c-1 DOWNTO 0);
        SIGNAL bus_readdatavalid_out    : OUT STD_LOGIC;
        SIGNAL bus_writewait_out        : OUT STD_LOGIC;
        SIGNAL bus_readwait_out         : OUT STD_LOGIC;

        -- Bus interface to SRAM
        SIGNAL fpu_rd_addr_out          : OUT STD_LOGIC_VECTOR(sram_depth_c-1 DOWNTO 0);
        SIGNAL fpu_wr_addr_out          : OUT STD_LOGIC_VECTOR(sram_depth_c-1 DOWNTO 0);        
        SIGNAL fpu_write_out            : OUT STD_LOGIC;
        SIGNAL fpu_write_wait_in        : IN STD_LOGIC;
        SIGNAL fpu_read_out             : OUT STD_LOGIC;
        SIGNAL fpu_read_wait_in         : IN STD_LOGIC;
        SIGNAL fpu_writedata_out        : OUT STD_LOGIC_VECTOR(ddr_data_width_c-1 DOWNTO 0);
        SIGNAL fpu_writebe_out          : OUT STD_LOGIC_VECTOR(ddr_data_width_c/8-1 downto 0);
        SIGNAL fpu_readdatavalid_in     : IN STD_LOGIC;
        SIGNAL fpu_readdata_in          : IN STD_LOGIC_VECTOR(ddr_data_width_c-1 DOWNTO 0);

        SIGNAL fpu_busy_vm_out          : OUT STD_LOGIC_VECTOR(1 DOWNTO 0);

        SIGNAL fpu_exe_in               : IN STD_LOGIC;

        SIGNAL fpu_exe_vm_in            : IN STD_LOGIC;

        SIGNAL fpu_exe_out              : OUT STD_LOGIC
    );
END COMPONENT;

COMPONENT falu_core IS
    PORT (
        SIGNAL clock_in             : IN STD_LOGIC;
        SIGNAL reset_in             : IN STD_LOGIC;

        SIGNAL step_in              : IN unsigned(sram_depth_c-1 DOWNTO 0);
        SIGNAL opcode_in            : IN fpu_opcode_t;
        SIGNAL input_ena_in         : IN STD_LOGIC;
        SIGNAL input_eof_in         : IN STD_LOGIC;
        SIGNAL input_last_in        : IN STD_LOGIC;
        SIGNAL input_fast_in        : IN STD_LOGIC;
        SIGNAL A_addr               : IN unsigned(sram_depth_c-1 DOWNTO 0);
        SIGNAL A_precision          : IN unsigned(2 downto 0);
        SIGNAL A_int                : IN STD_LOGIC;
        SIGNAL A_floor              : IN STD_LOGIC;
        SIGNAL A_abs                : IN STD_LOGIC;
        SIGNAL B_in                 : IN fp32_t;
        SIGNAL C_in                 : IN fp32_t;
        SIGNAL C2_in                : IN fp32_t;
        SIGNAL X_in                 : IN fp32_t;
        SIGNAL Y_in                 : IN fp32_t;

        SIGNAL output_ena_out       : OUT STD_LOGIC;
        SIGNAL output_eof_out       : OUT STD_LOGIC;
        SIGNAL output_last_out      : OUT STD_LOGIC;
        SIGNAL output_fast_out      : OUT STD_LOGIC;
        SIGNAL output_addr_out      : OUT unsigned(sram_depth_c-1 DOWNTO 0);
        SIGNAL output_precision_out : OUT unsigned(2 downto 0);
        SIGNAL output_out           : OUT fp32_t
    );
END COMPONENT;

COMPONENT falu IS
    PORT (
        SIGNAL clock_in             : IN STD_LOGIC;
        SIGNAL reset_in             : IN STD_LOGIC;

        SIGNAL step_in              : IN unsigned(sram_depth_c-1 DOWNTO 0);
        SIGNAL opcode_in            : IN fpu_opcode_t;
        SIGNAL input_ena_in         : IN STD_LOGIC;
        SIGNAL input_eof_in         : IN STD_LOGIC;
        SIGNAL input_last_in        : IN STD_LOGIC;
        SIGNAL input_fast_in        : IN STD_LOGIC;
        SIGNAL A_addr               : IN unsigned(sram_depth_c-1 DOWNTO 0);
        SIGNAL A_precision          : IN unsigned(2 downto 0);
        SIGNAL A_int                : IN STD_LOGIC;
        SIGNAL A_floor              : IN STD_LOGIC;
        SIGNAL A_abs                : IN STD_LOGIC;
        SIGNAL B_in                 : IN fp32_t;
        SIGNAL C_in                 : IN fp32_t;
        SIGNAL C2_in                : IN fp32_t;
        SIGNAL X_in                 : IN fp32_t;
        SIGNAL Y_in                 : IN fp32_t;

        SIGNAL output_ena_out       : OUT STD_LOGIC;
        SIGNAL output_step_out      : OUT unsigned(sram_depth_c-1 DOWNTO 0);
        SIGNAL output_opcode_out    : OUT fpu_opcode_t;
        SIGNAL output_eof_out       : OUT STD_LOGIC;
        SIGNAL output_last_out      : OUT STD_LOGIC;
        SIGNAL output_fast_out      : OUT STD_LOGIC;
        SIGNAL output_addr_out      : OUT unsigned(sram_depth_c-1 DOWNTO 0);
        SIGNAL output_precision_out : OUT unsigned(2 downto 0);
        SIGNAL output_out           : OUT fp32_t;
        SIGNAL output_C2_out        : OUT fp32_t
    );
END COMPONENT;

COMPONENT falu2 IS
    PORT (
        SIGNAL clock_in             : IN STD_LOGIC;
        SIGNAL reset_in             : IN STD_LOGIC;

        SIGNAL step_in              : IN unsigned(sram_depth_c-1 DOWNTO 0);
        SIGNAL opcode_in            : IN fpu_opcode_t;
        SIGNAL input_ena_in         : IN STD_LOGIC;
        SIGNAL input_eof_in         : IN STD_LOGIC;
        SIGNAL input_last_in        : IN STD_LOGIC;
        SIGNAL input_fast_in        : IN STD_LOGIC;
        SIGNAL A_addr               : IN unsigned(sram_depth_c-1 DOWNTO 0);
        SIGNAL A_precision          : IN unsigned(2 downto 0);
        SIGNAL A_floor              : IN STD_LOGIC;
        SIGNAL A_abs                : IN STD_LOGIC;
        SIGNAL B_in                 : IN fp32_t;
        SIGNAL C_in                 : IN fp32_t;
        SIGNAL X_in                 : IN fp32_t;
        SIGNAL Y_in                 : IN fp32_t;

        SIGNAL output_ena_out       : OUT STD_LOGIC;
        SIGNAL output_eof_out       : OUT STD_LOGIC;
        SIGNAL output_last_out      : OUT STD_LOGIC;
        SIGNAL output_fast_out      : OUT STD_LOGIC;
        SIGNAL output_addr_out      : OUT unsigned(sram_depth_c-1 DOWNTO 0);
        SIGNAL output_precision_out : OUT unsigned(2 downto 0);
        SIGNAL output_out           : OUT fp32_t
    );
END COMPONENT;

component fp2int is
   generic
   (
      WIDTH:integer;
      LATENCY:natural
   );
   port 
   (
      SIGNAL reset_in    : in std_logic;
      SIGNAL clock_in    : in std_logic;
      SIGNAL x_in        : in fp32_t;
      SIGNAL y_out       : out std_logic_vector(WIDTH-1 downto 0)
   );
end component;

component fpmax is
    generic
    (
        LATENCY:natural
    );
    port(
        SIGNAL clock_in : in std_logic;
        SIGNAL reset_in : in std_logic;
        SIGNAL x1_in    : in  fp32_t;
        SIGNAL x2_in    : in  fp32_t;
        SIGNAL y_out    : out fp32_t
    );
end component;

COMPONENT ddr_tx IS
    port(
        SIGNAL clock_in                 : IN STD_LOGIC;
        SIGNAL reset_in                 : IN STD_LOGIC;

        -- Bus interface for write master to DDR
        SIGNAL write_addr_in            : IN STD_LOGIC_VECTOR(dp_full_addr_width_c-1 DOWNTO 0);
        SIGNAL write_cs_in              : IN STD_LOGIC;
        SIGNAL write_in                 : IN STD_LOGIC;
        SIGNAL write_vector_in          : IN dp_vector_t;
        SIGNAL write_end_in             : IN vector_t;
        SIGNAL write_data_in            : IN STD_LOGIC_VECTOR(ddr_data_width_c-1 DOWNTO 0);
        SIGNAL write_wait_request_out   : OUT STD_LOGIC;
        SIGNAL write_burstlen_in        : IN burstlen_t;
        SIGNAL write_burstlen2_in       : IN burstlen2_t;
        SIGNAL write_burstlen3_in       : IN burstlen_t;

        SIGNAL ddr_awaddr_out           : OUT std_logic_vector(ddr_bus_width_c-1 downto 0);
        SIGNAL ddr_awlen_out            : OUT unsigned(ddr_burstlen_width_c-1 downto 0);
        SIGNAL ddr_awvalid_out          : OUT std_logic;
        SIGNAL ddr_waddr_out            : OUT std_logic_vector(ddr_bus_width_c-1 downto 0);
        SIGNAL ddr_wvalid_out           : OUT std_logic;
        SIGNAL ddr_wdata_out            : OUT std_logic_vector(ddr_data_width_c-1 downto 0);
        SIGNAL ddr_wlast_out            : OUT std_logic;
        SIGNAL ddr_wbe_out              : OUT std_logic_vector(ddr_data_byte_width_c-1 downto 0);
        SIGNAL ddr_awready_in           : IN std_logic;
        SIGNAL ddr_wready_in            : IN std_logic;
        SIGNAL ddr_bresp_in             : IN std_logic;

        SIGNAL ddr_awburst_out          : OUT std_logic_vector(1 downto 0);
        SIGNAL ddr_awcache_out          : OUT std_logic_vector(3 downto 0);
        SIGNAL ddr_awid_out             : OUT std_logic_vector(0 downto 0);
        SIGNAL ddr_awlock_out           : OUT std_logic_vector(0 downto 0);
        SIGNAL ddr_awprot_out           : OUT std_logic_vector(2 downto 0);
        SIGNAL ddr_awqos_out            : OUT std_logic_vector(3 downto 0);
        SIGNAL ddr_awsize_out           : OUT std_logic_vector(2 downto 0);
        SIGNAL ddr_bready_out           : OUT std_logic; 
        
        SIGNAL ddr_tx_busy_out          : OUT std_logic
        );
END COMPONENT;

COMPONENT ddr_rx IS
    port(
        SIGNAL clock_in                 : IN STD_LOGIC;
        SIGNAL reset_in                 : IN STD_LOGIC;

        -- Bus interface for read2 master to DDR
        SIGNAL read_addr_in             : IN STD_LOGIC_VECTOR(dp_full_addr_width_c-1 DOWNTO 0);
        SIGNAL read_cs_in               : IN STD_LOGIC;
        SIGNAL read_in                  : IN STD_LOGIC;
        SIGNAL read_vm_in               : IN STD_LOGIC;
        SIGNAL read_vector_in           : IN dp_vector_t;
        SIGNAL read_fork_in             : IN STD_LOGIC_VECTOR(fork_max_c-1 downto 0);
        SIGNAL read_start_in            : unsigned(ddr_vector_depth_c downto 0);
        SIGNAL read_end_in              : unsigned(ddr_vector_depth_c downto 0);
        SIGNAL read_data_ready_out      : OUT STD_LOGIC;
        SIGNAL read_fork_out            : OUT STD_LOGIC_VECTOR(fork_max_c-1 downto 0);
        SIGNAL read_data_wait_in        : IN STD_LOGIC;
        SIGNAL read_data_valid_out      : OUT STD_LOGIC;
        SIGNAL read_data_valid_vm_out   : OUT STD_LOGIC;
        SIGNAL read_data_out            : OUT STD_LOGIC_VECTOR(ddr_data_width_c-1 DOWNTO 0);
        SIGNAL read_wait_request_out    : OUT STD_LOGIC;
        SIGNAL read_burstlen_in         : IN burstlen_t;
        SIGNAL read_filler_data_in      : IN STD_LOGIC_VECTOR(2*data_width_c-1 downto 0);

        SIGNAL ddr_araddr_out           : OUT std_logic_vector(ddr_bus_width_c-1 downto 0);
        SIGNAL ddr_arlen_out            : OUT unsigned(ddr_burstlen_width_c-1 downto 0);
        SIGNAL ddr_arvalid_out          : OUT std_logic;
        SIGNAL ddr_rvalid_in            : IN std_logic;
        SIGNAL ddr_rlast_in             : IN std_logic;
        SIGNAL ddr_rdata_in             : IN std_logic_vector(ddr_data_width_c-1 downto 0);
        SIGNAL ddr_arready_in           : IN std_logic;
        SIGNAL ddr_rready_out           : OUT std_logic;
        SIGNAL ddr_arburst_out          : OUT std_logic_vector(1 downto 0);
        SIGNAL ddr_arcache_out          : OUT std_logic_vector(3 downto 0);
        SIGNAL ddr_arid_out             : OUT std_logic_vector(0 downto 0);
        SIGNAL ddr_arlock_out           : OUT std_logic_vector(0 downto 0);
        SIGNAL ddr_arprot_out           : OUT std_logic_vector(2 downto 0);
        SIGNAL ddr_arqos_out            : OUT std_logic_vector(3 downto 0); 
        SIGNAL ddr_arsize_out           : OUT std_logic_vector(2 downto 0)
        );
END COMPONENT;

COMPONENT axilite IS
   PORT( 
        SIGNAL clock_in                : IN STD_LOGIC;
        SIGNAL reset_in                : IN STD_LOGIC;

        SIGNAL axilite_araddr_in       : IN std_logic_vector(io_depth_c-1 downto 0);
        SIGNAL axilite_arvalid_in      : IN std_logic;
        SIGNAL axilite_arready_out     : OUT std_logic;
        SIGNAL axilite_rvalid_out      : OUT std_logic;
        SIGNAL axilite_rlast_out       : OUT std_logic;
        SIGNAL axilite_rdata_out       : OUT std_logic_vector(host_width_c-1 downto 0);
        SIGNAL axilite_rready_in       : IN std_logic; 
        SIGNAL axilite_rresp_out       : OUT std_logic_vector(1 downto 0);        

        SIGNAL axilite_awaddr_in       : IN std_logic_vector(io_depth_c-1 downto 0);
        SIGNAL axilite_awvalid_in      : IN std_logic;
        SIGNAL axilite_wvalid_in       : IN std_logic;
        SIGNAL axilite_wdata_in        : IN std_logic_vector(host_width_c-1 downto 0);
        SIGNAL axilite_awready_out     : OUT std_logic;
        SIGNAL axilite_wready_out      : OUT std_logic;
        SIGNAL axilite_bvalid_out      : OUT std_logic;
        SIGNAL axilite_bready_in       : IN std_logic;
        SIGNAL axilite_bresp_out       : OUT std_logic_vector(1 downto 0);
        
        SIGNAL bus_waddr_out           : OUT std_logic_vector(io_depth_c-1 downto 0);
        SIGNAL bus_raddr_out           : OUT std_logic_vector(io_depth_c-1 downto 0);
        SIGNAL bus_write_out           : OUT std_logic;
        SIGNAL bus_read_out            : OUT std_logic;
        SIGNAL bus_writedata_out       : OUT std_logic_vector(host_width_c-1 downto 0);
        SIGNAL bus_readdata_in         : IN std_logic_vector(host_width_c-1 downto 0);
        SIGNAL bus_readdatavalid_in    : IN std_logic;
        SIGNAL bus_writewait_in        : IN std_logic;
        SIGNAL bus_readwait_in         : IN std_logic
    );
END COMPONENT;

COMPONENT axi_read is
    generic (
        DATA_WIDTH      : integer:=32;
        FIFO_DEPTH      : integer:=4;
        FIFO_DATA_DEPTH : integer:=4;
        CCD             : boolean:=TRUE
    );
	port 
	(
        clock_in               : in std_logic;
        reset_in               : in std_logic;

        axislave_clock_in      : IN std_logic;
        axislave_araddr_in     : IN axi_araddr_t;
        axislave_arlen_in      : IN axi_arlen_t;
        axislave_arvalid_in    : IN axi_arvalid_t;
        axislave_arid_in       : IN axi_arid_t;
        axislave_arlock_in     : IN axi_arlock_t;
        axislave_arcache_in    : IN axi_arcache_t;
        axislave_arprot_in     : IN axi_arprot_t;
        axislave_arqos_in      : IN axi_arqos_t;
        axislave_rid_out       : OUT axi_rid_t;         
        axislave_rvalid_out    : OUT axi_rvalid_t;
        axislave_rlast_out     : OUT axi_rlast_t;
        axislave_rdata_out     : OUT STD_LOGIC_VECTOR(DATA_WIDTH-1 downto 0);
        axislave_rresp_out     : OUT axi_rresp_t;
        axislave_arready_out   : OUT axi_arready_t;
        axislave_rready_in     : IN axi_rready_t;
        axislave_arburst_in    : IN axi_arburst_t;
        axislave_arsize_in     : IN axi_arsize_t;
         
        aximaster_clock_in     : IN std_logic;
        aximaster_araddr_out   : OUT axi_araddr_t;
        aximaster_arlen_out    : OUT axi_arlen_t;
        aximaster_arvalid_out  : OUT axi_arvalid_t;
        aximaster_arid_out     : OUT axi_arid_t;
        aximaster_arlock_out   : OUT axi_arlock_t;
        aximaster_arcache_out  : OUT axi_arcache_t;
        aximaster_arprot_out   : OUT axi_arprot_t;
        aximaster_arqos_out    : OUT axi_arqos_t;
        aximaster_rid_in       : IN axi_rid_t;
        aximaster_rvalid_in    : IN axi_rvalid_t;
        aximaster_rlast_in     : IN axi_rlast_t;
        aximaster_rdata_in     : IN STD_LOGIC_VECTOR(DATA_WIDTH-1 downto 0);
        aximaster_rresp_in     : IN axi_rresp_t;
        aximaster_arready_in   : IN axi_arready_t;
        aximaster_rready_out   : OUT axi_rready_t;
        aximaster_arburst_out  : OUT axi_arburst_t;
        aximaster_arsize_out   : OUT axi_arsize_t
	);
end component;

COMPONENT axi_write is
    generic (
        DATA_WIDTH      : integer:=32;
        FIFO_DEPTH      : integer:=4;
        FIFO_DATA_DEPTH : integer:=4;
        CCD             : boolean:=TRUE
    );
	port 
	(
        clock_in               : in std_logic;
        reset_in               : in std_logic;

        axislave_clock_in           : IN std_logic;
        axislave_awaddr_in          : IN axi_awaddr_t;
        axislave_awlen_in           : IN axi_awlen_t;
        axislave_awvalid_in         : IN axi_awvalid_t;
        axislave_wvalid_in          : IN axi_wvalid_t;
        axislave_wdata_in           : IN STD_LOGIC_VECTOR(DATA_WIDTH-1 downto 0);
        axislave_wlast_in           : IN axi_wlast_t;
        axislave_wstrb_in           : IN STD_LOGIC_VECTOR((DATA_WIDTH/8)-1 downto 0);
        axislave_awready_out        : OUT axi_awready_t;
        axislave_wready_out         : OUT axi_wready_t;
        axislave_bresp_out          : OUT axi_bresp_t;
        axislave_bid_out            : OUT axi_bid_t;
        axislave_bvalid_out         : OUT axi_bvalid_t;
        axislave_awburst_in         : IN axi_awburst_t;
        axislave_awcache_in         : IN axi_awcache_t;
        axislave_awid_in            : IN axi_awid_t;
        axislave_awlock_in          : IN axi_awlock_t;
        axislave_awprot_in          : IN axi_awprot_t;
        axislave_awqos_in           : IN axi_awqos_t;
        axislave_awsize_in          : IN axi_awsize_t;
        axislave_bready_in          : IN axi_bready_t;
       
        aximaster_clock_in          : IN std_logic;
        aximaster_awaddr_out        : OUT axi_awaddr_t;
        aximaster_awlen_out         : OUT axi_awlen_t;
        aximaster_awvalid_out       : OUT axi_awvalid_t;
        aximaster_wvalid_out        : OUT axi_wvalid_t;
        aximaster_wdata_out         : OUT STD_LOGIC_VECTOR(DATA_WIDTH-1 downto 0);
        aximaster_wlast_out         : OUT axi_wlast_t;
        aximaster_wstrb_out         : OUT STD_LOGIC_VECTOR((DATA_WIDTH/8)-1 downto 0);
        aximaster_awready_in        : IN axi_awready_t;
        aximaster_wready_in         : IN axi_wready_t;
        aximaster_bresp_in          : IN axi_bresp_t;
        aximaster_bid_in            : IN axi_bid_t;
        aximaster_bvalid_in         : IN axi_bvalid_t;
        aximaster_awburst_out       : OUT axi_awburst_t;
        aximaster_awcache_out       : OUT axi_awcache_t;
        aximaster_awid_out          : OUT axi_awid_t;
        aximaster_awlock_out        : OUT axi_awlock_t;
        aximaster_awprot_out        : OUT axi_awprot_t;
        aximaster_awqos_out         : OUT axi_awqos_t;
        aximaster_awsize_out        : OUT axi_awsize_t;
        aximaster_bready_out        : OUT axi_bready_t
	);
end COMPONENT;

component axi_resize_write is
   generic (
      MASTER_DATA_WIDTH  : integer:=128;
      SLAVE_DATA_WIDTH   : integer:=32;
      FIFO_DEPTH         : integer:=4;
      FIFO_DATA_DEPTH    : integer:=4;
      CCD                : boolean:=TRUE
   );
   port 
   (
      clock_in                    : in std_logic;
      reset_in                    : in std_logic;

      -- Slace port
      axislave_clock_in           : IN std_logic;
      axislave_awaddr_in          : IN axi_awaddr_t;
      axislave_awlen_in           : IN axi_awlen_t;
      axislave_awvalid_in         : IN axi_awvalid_t;
      axislave_wvalid_in          : IN axi_wvalid_t;
      axislave_wdata_in           : IN STD_LOGIC_VECTOR(SLAVE_DATA_WIDTH-1 downto 0);
      axislave_wlast_in           : IN axi_wlast_t;
      axislave_wstrb_in           : IN STD_LOGIC_VECTOR((SLAVE_DATA_WIDTH/8)-1 downto 0);
      axislave_awready_out        : OUT axi_awready_t;
      axislave_wready_out         : OUT axi_wready_t;
      axislave_bresp_out          : OUT axi_bresp_t;
      axislave_bid_out            : OUT axi_bid_t;
      axislave_bvalid_out         : OUT axi_bvalid_t;
      axislave_awburst_in         : IN axi_awburst_t;
      axislave_awcache_in         : IN axi_awcache_t;
      axislave_awid_in            : IN axi_awid_t;
      axislave_awlock_in          : IN axi_awlock_t;
      axislave_awprot_in          : IN axi_awprot_t;
      axislave_awqos_in           : IN axi_awqos_t;
      axislave_awsize_in          : IN axi_awsize_t;
      axislave_bready_in          : IN axi_bready_t;
      
      -- Master port #1
      aximaster_clock_in          : IN std_logic;
      aximaster_awaddr_out        : OUT axi_awaddr_t;
      aximaster_awlen_out         : OUT axi_awlen_t;
      aximaster_awvalid_out       : OUT axi_awvalid_t;
      aximaster_wvalid_out        : OUT axi_wvalid_t;
      aximaster_wdata_out         : OUT STD_LOGIC_VECTOR(MASTER_DATA_WIDTH-1 downto 0);
      aximaster_wlast_out         : OUT axi_wlast_t;
      aximaster_wstrb_out         : OUT STD_LOGIC_VECTOR((MASTER_DATA_WIDTH/8)-1 downto 0);
      aximaster_awready_in        : IN axi_awready_t;
      aximaster_wready_in         : IN axi_wready_t;
      aximaster_bresp_in          : IN axi_bresp_t;
      aximaster_bid_in            : IN axi_bid_t;
      aximaster_bvalid_in         : IN axi_bvalid_t;
      aximaster_awburst_out       : OUT axi_awburst_t;
      aximaster_awcache_out       : OUT axi_awcache_t;
      aximaster_awid_out          : OUT axi_awid_t;
      aximaster_awlock_out        : OUT axi_awlock_t;
      aximaster_awprot_out        : OUT axi_awprot_t;
      aximaster_awqos_out         : OUT axi_awqos_t;
      aximaster_awsize_out        : OUT axi_awsize_t;
      aximaster_bready_out        : OUT axi_bready_t
   );
end component;

COMPONENT axi_resize_read is
   generic (
      SLAVE_DATA_WIDTH   : integer:=32;
      MASTER_DATA_WIDTH  : integer:=128;
      FIFO_DEPTH         : integer:=4;
      FIFO_DATA_DEPTH    : integer:=4;
      CCD                : boolean:=TRUE      
   );
   port 
   (
      clock_in               : in std_logic;
      reset_in               : in std_logic;

      -- Slace port
      axislave_clock_in      : IN std_logic;
      axislave_araddr_in     : IN axi_araddr_t;
      axislave_arlen_in      : IN axi_arlen_t;
      axislave_arvalid_in    : IN axi_arvalid_t;
      axislave_arid_in       : IN axi_arid_t;
      axislave_arlock_in     : IN axi_arlock_t;
      axislave_arcache_in    : IN axi_arcache_t;
      axislave_arprot_in     : IN axi_arprot_t;
      axislave_arqos_in      : IN axi_arqos_t;
      axislave_rid_out       : OUT axi_rid_t;         
      axislave_rvalid_out    : OUT axi_rvalid_t;
      axislave_rlast_out     : OUT axi_rlast_t;
      axislave_rdata_out     : OUT STD_LOGIC_VECTOR(SLAVE_DATA_WIDTH-1 downto 0);
      axislave_rresp_out     : OUT axi_rresp_t;
      axislave_arready_out   : OUT axi_arready_t;
      axislave_rready_in     : IN axi_rready_t;
      axislave_arburst_in    : IN axi_arburst_t;
      axislave_arsize_in     : IN axi_arsize_t;

      -- Master port #1
      aximaster_clock_in     : IN std_logic;
      aximaster_araddr_out   : OUT axi_araddr_t;
      aximaster_arlen_out    : OUT axi_arlen_t;
      aximaster_arvalid_out  : OUT axi_arvalid_t;
      aximaster_arid_out     : OUT axi_arid_t;
      aximaster_arlock_out   : OUT axi_arlock_t;
      aximaster_arcache_out  : OUT axi_arcache_t;
      aximaster_arprot_out   : OUT axi_arprot_t;
      aximaster_arqos_out    : OUT axi_arqos_t;
      aximaster_rid_in       : IN axi_rid_t;
      aximaster_rvalid_in    : IN axi_rvalid_t;
      aximaster_rlast_in     : IN axi_rlast_t;
      aximaster_rdata_in     : IN STD_LOGIC_VECTOR(MASTER_DATA_WIDTH-1 downto 0);
      aximaster_rresp_in     : IN axi_rresp_t;
      aximaster_arready_in   : IN axi_arready_t;
      aximaster_rready_out   : OUT axi_rready_t;
      aximaster_arburst_out  : OUT axi_arburst_t;
      aximaster_arsize_out   : OUT axi_arsize_t
   );
end COMPONENT;

constant MAX_SLAVE_PORT:integer:=3;

COMPONENT axi_merge_read is
    generic (
        NUM_SLAVE_PORT     : integer:=3;
        FIFO_CMD_DEPTH     : integer_array(2 downto 0);
        FIFO_DATA_DEPTH    : integer_array(2 downto 0);
        FIFO_W_CMD_DEPTH   : integer;
        FIFO_W_DATA_DEPTH  : integer
    );
	port 
	(
        clock_in                : IN std_logic;
        reset_in                : IN std_logic;

        axislavew_araddr_in     : IN axi_araddr_t:=(others=>'0');
        axislavew_arlen_in      : IN axi_arlen_t:=(others=>'0');
        axislavew_arvalid_in    : IN axi_arvalid_t:='0';     
        axislavew_arid_in       : IN axi_arid_t:=(others=>'0');
        axislavew_arlock_in     : IN axi_arlock_t:=(others=>'0');
        axislavew_arcache_in    : IN axi_arcache_t:=(others=>'0');
        axislavew_arprot_in     : IN axi_arprot_t:=(others=>'0');
        axislavew_arqos_in      : IN axi_arqos_t:=(others=>'0');
        axislavew_rid_out       : OUT axi_rid_t:=(others=>'0');
        axislavew_rvalid_out    : OUT axi_rvalid_t;
        axislavew_rlast_out     : OUT axi_rlast_t;
        axislavew_rdata_out     : OUT axi_rdata64_t;
        axislavew_rresp_out     : OUT axi_rresp_t;
        axislavew_arready_out   : OUT axi_arready_t;
        axislavew_rready_in     : IN axi_rready_t:='0';
        axislavew_arburst_in    : IN axi_arburst_t:=(others=>'0');
        axislavew_arsize_in     : IN axi_arsize_t:=(others=>'0');
        
        axislave_araddrs_in     : IN axi_araddrs_t(MAX_SLAVE_PORT-1 downto 0):=(others=>(others=>'0'));
        axislave_arlens_in      : IN axi_arlens_t(MAX_SLAVE_PORT-1 downto 0):=(others=>(others=>'0'));
        axislave_arvalids_in    : IN axi_arvalids_t(MAX_SLAVE_PORT-1 downto 0):=(others=>'0');     
        axislave_arids_in       : IN axi_arids_t(MAX_SLAVE_PORT-1 downto 0):=(others=>(others=>'0'));
        axislave_arlocks_in     : IN axi_arlocks_t(MAX_SLAVE_PORT-1 downto 0):=(others=>(others=>'0'));
        axislave_arcaches_in    : IN axi_arcaches_t(MAX_SLAVE_PORT-1 downto 0):=(others=>(others=>'0'));
        axislave_arprots_in     : IN axi_arprots_t(MAX_SLAVE_PORT-1 downto 0):=(others=>(others=>'0'));
        axislave_arqoss_in      : IN axi_arqoss_t(MAX_SLAVE_PORT-1 downto 0):=(others=>(others=>'0'));
        axislave_rids_out       : OUT axi_rids_t(MAX_SLAVE_PORT-1 downto 0):=(others=>(others=>'0'));
        axislave_rvalids_out    : OUT axi_rvalids_t(MAX_SLAVE_PORT-1 downto 0);
        axislave_rlasts_out     : OUT axi_rlasts_t(MAX_SLAVE_PORT-1 downto 0);
        axislave_rdatas_out     : OUT axi_rdata64s_t(MAX_SLAVE_PORT-1 downto 0);
        axislave_rresps_out     : OUT axi_rresps_t(MAX_SLAVE_PORT-1 downto 0);
        axislave_arreadys_out   : OUT axi_arreadys_t(MAX_SLAVE_PORT-1 downto 0);
        axislave_rreadys_in     : IN axi_rreadys_t(MAX_SLAVE_PORT-1 downto 0):=(others=>'0');
        axislave_arbursts_in    : IN axi_arbursts_t(MAX_SLAVE_PORT-1 downto 0):=(others=>(others=>'0'));
        axislave_arsizes_in     : IN axi_arsizes_t(MAX_SLAVE_PORT-1 downto 0):=(others=>(others=>'0'));
        
        aximaster_araddr_out    : OUT axi_araddr_t;
        aximaster_arlen_out     : OUT axi_arlen_t;
        aximaster_arvalid_out   : OUT axi_arvalid_t;
        aximaster_arid_out      : OUT axi_arid_t;
        aximaster_arlock_out    : OUT axi_arlock_t;
        aximaster_arcache_out   : OUT axi_arcache_t;
        aximaster_arprot_out    : OUT axi_arprot_t;
        aximaster_arqos_out     : OUT axi_arqos_t;
        aximaster_rid_in        : IN axi_rid_t;              
        aximaster_rvalid_in     : IN axi_rvalid_t;
        aximaster_rlast_in      : IN axi_rlast_t;
        aximaster_rdata_in      : IN axi_rdata128_t;
        aximaster_rresp_in      : IN axi_rresp_t;
        aximaster_arready_in    : IN axi_arready_t;
        aximaster_rready_out    : OUT axi_rready_t;
        aximaster_arburst_out   : OUT axi_arburst_t;
        aximaster_arsize_out    : OUT axi_arsize_t
	);
end COMPONENT;

component axi_merge_write is
    generic (
        NUM_SLAVE_PORT     : integer:=3;
        FIFO_CMD_DEPTH     : integer_array(2 downto 0);
        FIFO_DATA_DEPTH    : integer_array(2 downto 0);
        FIFO_W_CMD_DEPTH   : integer;
        FIFO_W_DATA_DEPTH  : integer
    );
	port 
	(
        clock_in           : IN std_logic;
        reset_in           : IN std_logic;
        
        axislavew_awaddr_in          : IN axi_awaddr_t;
        axislavew_awlen_in           : IN axi_awlen_t;
        axislavew_awvalid_in         : IN axi_awvalid_t;
        axislavew_wvalid_in          : IN axi_wvalid_t;
        axislavew_wdata_in           : IN axi_wdata64_t;
        axislavew_wlast_in           : IN axi_wlast_t;
        axislavew_wstrb_in           : IN axi_wstrb8_t;
        axislavew_awready_out        : OUT axi_awready_t;
        axislavew_wready_out         : OUT axi_wready_t;
        axislavew_bresp_out          : OUT axi_bresp_t;
        axislavew_bid_out            : OUT axi_bid_t;
        axislavew_bvalid_out         : OUT axi_bvalid_t;
        axislavew_awburst_in         : IN axi_awburst_t;
        axislavew_awcache_in         : IN axi_awcache_t;
        axislavew_awid_in            : IN axi_awid_t;
        axislavew_awlock_in          : IN axi_awlock_t;
        axislavew_awprot_in          : IN axi_awprot_t;
        axislavew_awqos_in           : IN axi_awqos_t;
        axislavew_awsize_in          : IN axi_awsize_t;
        axislavew_bready_in          : IN axi_bready_t;
        
        axislave_awaddrs_in          : IN axi_awaddrs_t(MAX_SLAVE_PORT-1 downto 0);
        axislave_awlens_in           : IN axi_awlens_t(MAX_SLAVE_PORT-1 downto 0);
        axislave_awvalids_in         : IN axi_awvalids_t(MAX_SLAVE_PORT-1 downto 0);
        axislave_wvalids_in          : IN axi_wvalids_t(MAX_SLAVE_PORT-1 downto 0);
        axislave_wdatas_in           : IN axi_wdata64s_t(MAX_SLAVE_PORT-1 downto 0);
        axislave_wlasts_in           : IN axi_wlasts_t(MAX_SLAVE_PORT-1 downto 0);
        axislave_wstrbs_in           : IN axi_wstrb8s_t(MAX_SLAVE_PORT-1 downto 0);
        axislave_awreadys_out        : OUT axi_awreadys_t(MAX_SLAVE_PORT-1 downto 0);
        axislave_wreadys_out         : OUT axi_wreadys_t(MAX_SLAVE_PORT-1 downto 0);
        axislave_bresps_out          : OUT axi_bresps_t(MAX_SLAVE_PORT-1 downto 0);
        axislave_bids_out            : OUT axi_bids_t(MAX_SLAVE_PORT-1 downto 0);
        axislave_bvalids_out         : OUT axi_bvalids_t(MAX_SLAVE_PORT-1 downto 0);
        axislave_awbursts_in         : IN axi_awbursts_t(MAX_SLAVE_PORT-1 downto 0);
        axislave_awcaches_in         : IN axi_awcaches_t(MAX_SLAVE_PORT-1 downto 0);
        axislave_awids_in            : IN axi_awids_t(MAX_SLAVE_PORT-1 downto 0);
        axislave_awlocks_in          : IN axi_awlocks_t(MAX_SLAVE_PORT-1 downto 0);
        axislave_awprots_in          : IN axi_awprots_t(MAX_SLAVE_PORT-1 downto 0);
        axislave_awqoss_in           : IN axi_awqoss_t(MAX_SLAVE_PORT-1 downto 0);
        axislave_awsizes_in          : IN axi_awsizes_t(MAX_SLAVE_PORT-1 downto 0);
        axislave_breadys_in          : IN axi_breadys_t(MAX_SLAVE_PORT-1 downto 0);
        
        aximaster_awaddr_out         : OUT axi_awaddr_t;
        aximaster_awlen_out          : OUT axi_awlen_t;
        aximaster_awvalid_out        : OUT axi_awvalid_t;
        aximaster_wvalid_out         : OUT axi_wvalid_t;
        aximaster_wdata_out          : OUT axi_wdata128_t;
        aximaster_wdata_mask_out     : OUT std_logic_vector(1 downto 0);
        aximaster_wlast_out          : OUT axi_wlast_t;
        aximaster_wstrb_out          : OUT axi_wstrb16_t;
        aximaster_awready_in         : IN axi_awready_t;
        aximaster_wready_in          : IN axi_wready_t;
        aximaster_bresp_in           : IN axi_bresp_t;
        aximaster_bid_in             : IN axi_bid_t;
        aximaster_bvalid_in          : IN axi_bvalid_t;
        aximaster_awburst_out        : OUT axi_awburst_t;
        aximaster_awcache_out        : OUT axi_awcache_t;
        aximaster_awid_out           : OUT axi_awid_t;
        aximaster_awlock_out         : OUT axi_awlock_t;
        aximaster_awprot_out         : OUT axi_awprot_t;
        aximaster_awqos_out          : OUT axi_awqos_t;
        aximaster_awsize_out         : OUT axi_awsize_t;
        aximaster_bready_out         : OUT axi_bready_t
	);
end component;

component axi_split_read is
   generic (
      NUM_MASTER_PORT     : integer:=5;
      NUM_MASTER_PORT_USED: integer:=5;
      BAR_LO_BIT          : integer_array(4 downto 0);
      BAR_HI_BIT          : integer_array(4 downto 0);
      BAR                 : integer_array(4 downto 0)
   );
   port 
   (
      clock_in                : in std_logic;
      reset_in                : in std_logic;
               
      -- Slave port 
      axislave_araddr_in      : IN axi_araddr_t;
      axislave_arlen_in       : IN axi_arlen_t;
      axislave_arvalid_in     : IN axi_arvalid_t;
      axislave_arid_in        : IN axi_arid_t;
      axislave_arlock_in      : IN axi_arlock_t;
      axislave_arcache_in     : IN axi_arcache_t;
      axislave_arprot_in      : IN axi_arprot_t;
      axislave_arqos_in       : IN axi_arqos_t;
      axislave_rid_out        : OUT axi_rid_t;          
      axislave_rvalid_out     : OUT axi_rvalid_t;
      axislave_rlast_out      : OUT axi_rlast_t;
      axislave_rdata_out      : OUT axi_rdata_t;
      axislave_rresp_out      : OUT axi_rresp_t;
      axislave_arready_out    : OUT axi_arready_t;
      axislave_rready_in      : IN axi_rready_t;
      axislave_arburst_in     : IN axi_arburst_t;
      axislave_arsize_in      : IN axi_arsize_t;

      -- Master ports
      aximaster_araddrs_out   : OUT axi_araddrs_t(NUM_MASTER_PORT-1 downto 0);
      aximaster_arlens_out    : OUT axi_arlens_t(NUM_MASTER_PORT-1 downto 0);
      aximaster_arvalids_out  : OUT axi_arvalids_t(NUM_MASTER_PORT-1 downto 0);    
      aximaster_arids_out     : OUT axi_arids_t(NUM_MASTER_PORT-1 downto 0);
      aximaster_arlocks_out   : OUT axi_arlocks_t(NUM_MASTER_PORT-1 downto 0);
      aximaster_arcaches_out  : OUT axi_arcaches_t(NUM_MASTER_PORT-1 downto 0);
      aximaster_arprots_out   : OUT axi_arprots_t(NUM_MASTER_PORT-1 downto 0);
      aximaster_arqoss_out    : OUT axi_arqoss_t(NUM_MASTER_PORT-1 downto 0);
      aximaster_rids_in       : IN axi_rids_t(NUM_MASTER_PORT-1 downto 0):=(others=>(others=>'0'));
      aximaster_rvalids_in    : IN axi_rvalids_t(NUM_MASTER_PORT-1 downto 0):=(others=>'0');
      aximaster_rlasts_in     : IN axi_rlasts_t(NUM_MASTER_PORT-1 downto 0):=(others=>'0');
      aximaster_rdatas_in     : IN axi_rdatas_t(NUM_MASTER_PORT-1 downto 0):=(others=>(others=>'0'));
      aximaster_rresps_in     : IN axi_rresps_t(NUM_MASTER_PORT-1 downto 0):=(others=>(others=>'0'));
      aximaster_arreadys_in   : IN axi_arreadys_t(NUM_MASTER_PORT-1 downto 0):=(others=>'0');
      aximaster_rreadys_out   : OUT axi_rreadys_t(NUM_MASTER_PORT-1 downto 0);
      aximaster_arbursts_out  : OUT axi_arbursts_t(NUM_MASTER_PORT-1 downto 0);
      aximaster_arsizes_out   : OUT axi_arsizes_t(NUM_MASTER_PORT-1 downto 0)
   );
end component;

component axi_split_write is
   generic (
      NUM_MASTER_PORT     : integer:=5;
      NUM_MASTER_PORT_USED: integer:=5;
      BAR_LO_BIT          : integer_array(4 downto 0);
      BAR_HI_BIT          : integer_array(4 downto 0);
      BAR                 : integer_array(4 downto 0)
   );
   port 
   (
      clock_in                   : in std_logic;
      reset_in                   : in std_logic;
            
      axislave_awaddr_in         : IN axi_awaddr_t;
      axislave_awlen_in          : IN axi_awlen_t;
      axislave_awvalid_in        : IN axi_awvalid_t;
      axislave_wvalid_in         : IN axi_wvalid_t;
      axislave_wdata_in          : IN axi_wdata_t;
      axislave_wlast_in          : IN axi_wlast_t;
      axislave_wstrb_in          : IN axi_wstrb_t;
      axislave_awready_out       : OUT axi_awready_t;
      axislave_wready_out        : OUT axi_wready_t;
      axislave_bresp_out         : OUT axi_bresp_t;
      axislave_bid_out           : OUT axi_bid_t;
      axislave_bvalid_out        : OUT axi_bvalid_t;
      axislave_awburst_in        : IN axi_awburst_t;
      axislave_awcache_in        : IN axi_awcache_t;
      axislave_awid_in           : IN axi_awid_t;
      axislave_awlock_in         : IN axi_awlock_t;
      axislave_awprot_in         : IN axi_awprot_t;
      axislave_awqos_in          : IN axi_awqos_t;
      axislave_awsize_in         : IN axi_awsize_t;
      axislave_bready_in         : IN axi_bready_t;

      -- Slave port
      aximaster_awaddrs_out      : OUT axi_awaddrs_t(NUM_MASTER_PORT-1 downto 0);
      aximaster_awlens_out       : OUT axi_awlens_t(NUM_MASTER_PORT-1 downto 0);
      aximaster_awvalids_out     : OUT axi_awvalids_t(NUM_MASTER_PORT-1 downto 0);
      aximaster_wvalids_out      : OUT axi_wvalids_t(NUM_MASTER_PORT-1 downto 0);
      aximaster_wdatas_out       : OUT axi_wdatas_t(NUM_MASTER_PORT-1 downto 0);
      aximaster_wlasts_out       : OUT axi_wlasts_t(NUM_MASTER_PORT-1 downto 0);
      aximaster_wstrbs_out       : OUT axi_wstrbs_t(NUM_MASTER_PORT-1 downto 0);
      aximaster_awreadys_in      : IN axi_awreadys_t(NUM_MASTER_PORT-1 downto 0):=(others=>'0');
      aximaster_wreadys_in       : IN axi_wreadys_t(NUM_MASTER_PORT-1 downto 0):=(others=>'0');
      aximaster_bresps_in        : IN axi_bresps_t(NUM_MASTER_PORT-1 downto 0):=(others=>(others=>'0'));
      aximaster_bids_in          : IN axi_bids_t(NUM_MASTER_PORT-1 downto 0):=(others=>(others=>'0'));
      aximaster_bvalids_in       : IN axi_bvalids_t(NUM_MASTER_PORT-1 downto 0):=(others=>'0');
      aximaster_awbursts_out     : OUT axi_awbursts_t(NUM_MASTER_PORT-1 downto 0);
      aximaster_awcaches_out     : OUT axi_awcaches_t(NUM_MASTER_PORT-1 downto 0);
      aximaster_awids_out        : OUT axi_awids_t(NUM_MASTER_PORT-1 downto 0);
      aximaster_awlocks_out      : OUT axi_awlocks_t(NUM_MASTER_PORT-1 downto 0);
      aximaster_awprots_out      : OUT axi_awprots_t(NUM_MASTER_PORT-1 downto 0);
      aximaster_awqoss_out       : OUT axi_awqoss_t(NUM_MASTER_PORT-1 downto 0);
      aximaster_awsizes_out      : OUT axi_awsizes_t(NUM_MASTER_PORT-1 downto 0);
      aximaster_breadys_out      : OUT axi_breadys_t(NUM_MASTER_PORT-1 downto 0)        
   );
end component;
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
