minhthangbk/ztachip/(commit log)

2026-01-02 Fix Verilog code generation
    [afifo.vhd, chat.cpp, falu.vhd, falu2.vhd, falu_core.vhd, main.vhd]
2026-02-01 Improve timing. Fix compilation warning
    [axilite.vhd, chat.cpp, dp_fetch.vhd, falu.vhd, falu_core.vhd, fifo.vhd, fpu.vhd]
2026-02-21 Add support for Ethernet LLM model now is downloaded to the FPGA board by Ethernet that comes with Arty devkit, extra SSD shield no longer required to run LLM example. LLM sampling algo is improved f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
    [axi_apb_bridge.vhd, axi_stream_read.vhd, axi_stream_write.vhd, chat.cpp, ethlite.vhd, gpio.vhd]
